Nicomedes77/PlasticBot_v1.0/Modelos 3D/Hardware v1/imagenes/LCD 20x04 (encastre).jpg

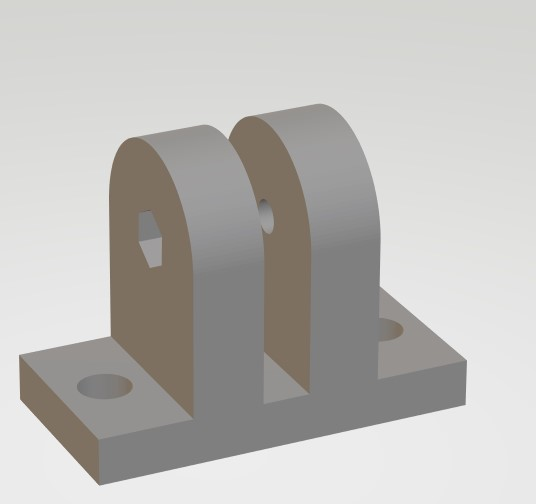
Modelos 3D/Hardware v1/imagenes/LCD 20x04 (encastre).jpg
