Nicomedes77/PlasticBot_v1.0/Modelos 3D/Hardware v1/imagenes/soporte NEMA17.jpg

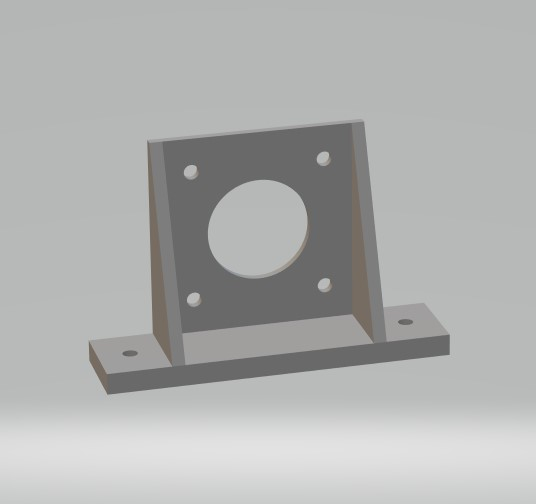
Modelos 3D/Hardware v1/imagenes/soporte NEMA17.jpg
