Nicomedes77/PlasticBot_v1.0/README.md

# Proyecto PlasticBot
- Proyecto colaborativo que busca transformar botellas PET en filamento plastico para impresoras 3D.
- Trabajo final de la carrera de Especialización de Sistemas Embebidos de FIUBA.
- Orientado a instituciones educativas que necesiten filamento para sus impresoras 3D.
