Nicomedes77/PlasticBot_v1.0/Modelos 3D/Hardware v1/imagenes/Encaste para bobina colectora_parteC.jpg

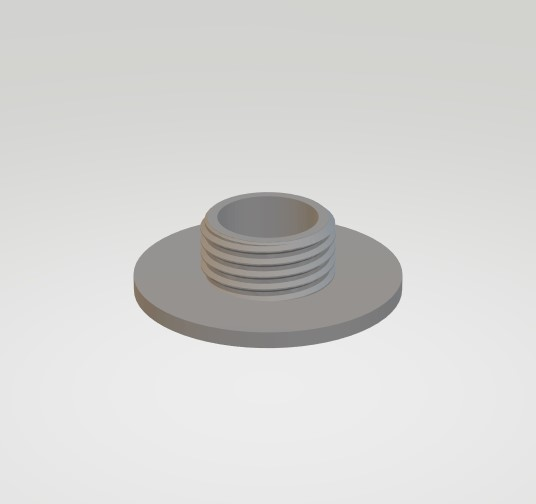
Modelos 3D/Hardware v1/imagenes/Encaste para bobina colectora_parteC.jpg
