Nicomedes77/PlasticBot_v1.0/Modelos 3D/Hardware v1/imagenes/filador tira PET.jpg

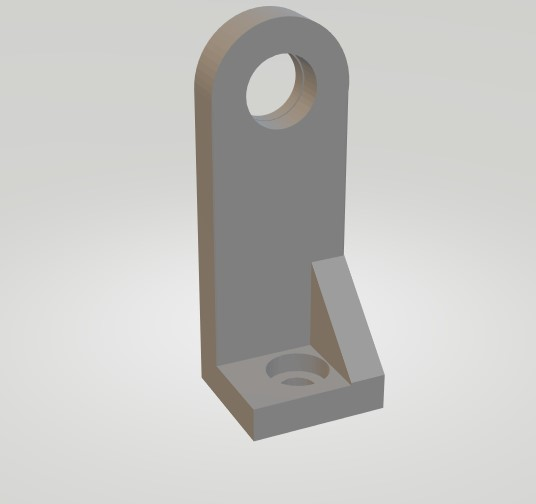
Modelos 3D/Hardware v1/imagenes/filador tira PET.jpg
