Nicomedes77/PlasticBot_v1.0/Modelos 3D/Hardware v1/imagenes/guia_tapa_der.jpg

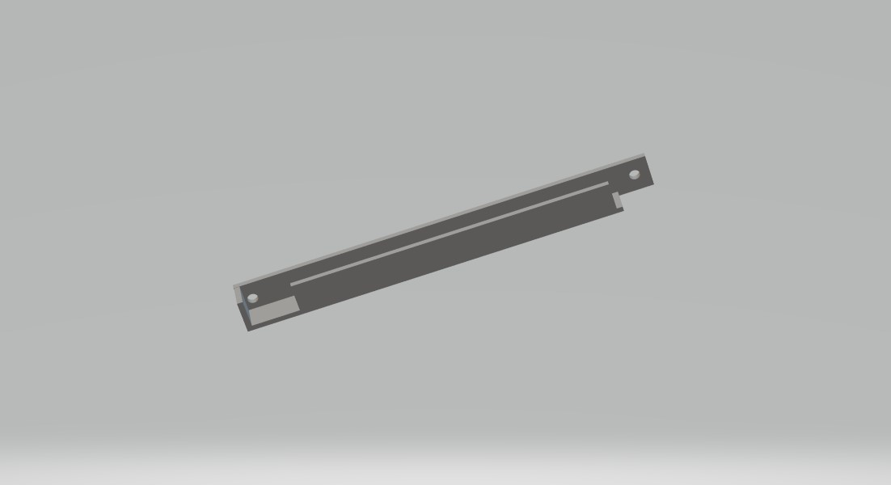
Modelos 3D/Hardware v1/imagenes/guia_tapa_der.jpg
