Nicomedes77/PlasticBot_v1.0/Modelos 3D/Hardware v1/imagenes/guia_tapa_izq.jpg

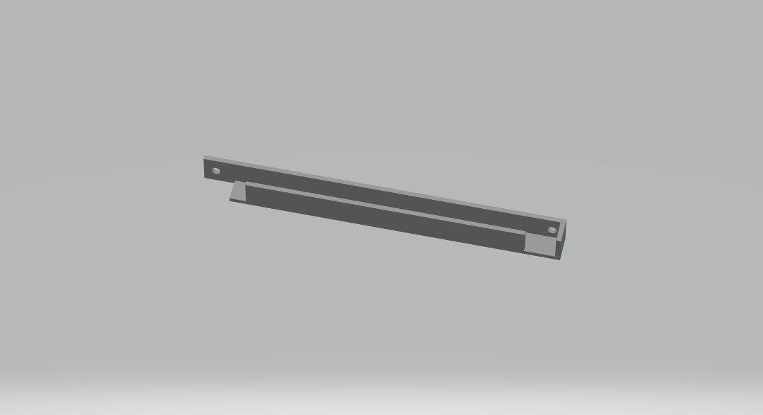
Modelos 3D/Hardware v1/imagenes/guia_tapa_izq.jpg
