Nicomedes77/PlasticBot_v1.0/Modelos 3D/Hardware v1/imagenes/rollo tira PET.png

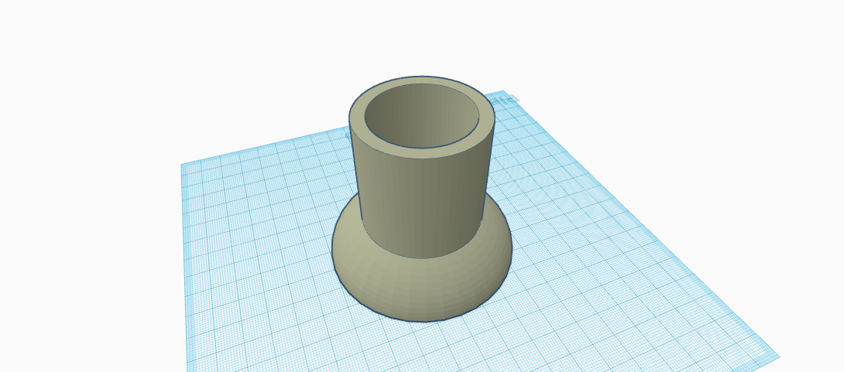
Modelos 3D/Hardware v1/imagenes/rollo tira PET.png
