Nicomedes77/PlasticBot_v1.0/Modelos 3D/Hardware v1/imagenes/Soporte bobina colector filamento parteB.jpg

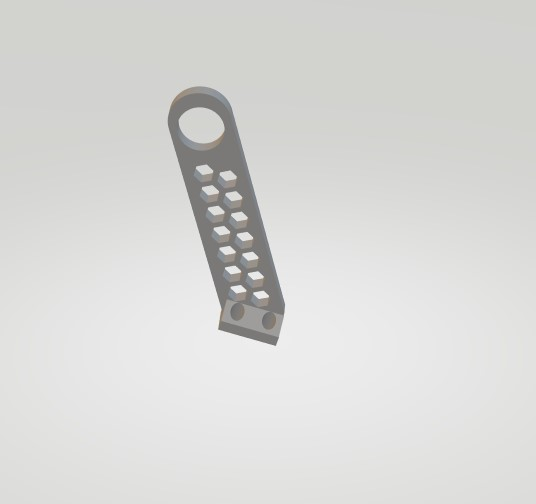
Modelos 3D/Hardware v1/imagenes/Soporte bobina colector filamento parteB.jpg
