Nicomedes77/PlasticBot_v1.0/Modelos 3D/Hardware v1/imagenes/soporte_sensor_filamento.jpg

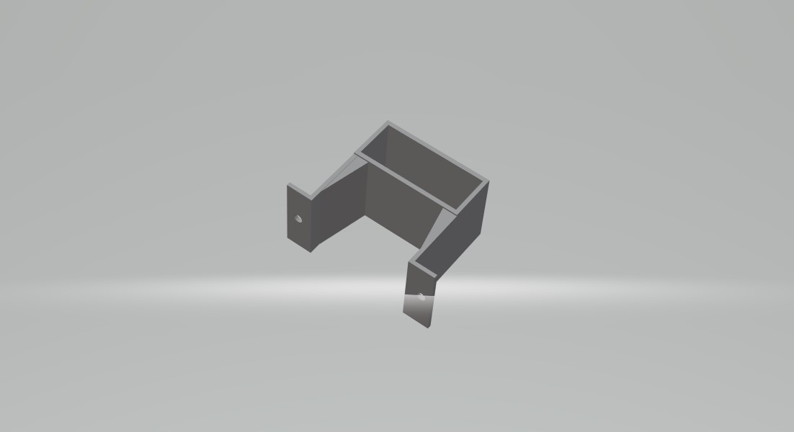
Modelos 3D/Hardware v1/imagenes/soporte_sensor_filamento.jpg
