Nicomedes77/PlasticBot_v1.0/BOM.xlsx

Sheet: Electronica & accesorios 3D
Nombre | cantidad | Nota
Placa de desarrollo "Bluepill" (STM32F103C8T6) (https://drive.google.com/file/d/1hpQ76dLVYaI5o_rDVkLO2Ne1s6q506t4/view?usp=sharing) | 1
Módulo MOSFET IRF520N (https://drive.google.com/file/d/1cJZWBD_wcfqCogvwuu_0CMX1WqDuURyV/view?usp=sharing) | 1
Módulo BUZZER (https://drive.google.com/file/d/1bJPctQ90iFLyjyye83Ye11f-dC5BXUkv/view?usp=sharing) | 1
Led 5 mm (https://drive.google.com/file/d/1oGvvgqCxScbAKbMWBlhJqRlZeoV0u4r3/view?usp=sharing) | 1
resistencia 330 ohm / 1/8W (https://drive.google.com/file/d/1HIooyIruoW-4rPtgbwAZOv_i-Ot9C7bt/view?usp=sharing) | 1
resistencia 4.7 Kohm / 1/8W (https://drive.google.com/file/d/1ij4iOs_i9iZRbYxjXlwnQBV02DJ9Dd3c/view?usp=sharing) | 1
capacitor electrolitico 10 uf / 50V (https://drive.google.com/file/d/1pf3eecrNbL37Hb7Q81hdsruip2whxTfo/view?usp=sharing) | 1
capacitor electrolitico 100 uf / 50V (https://drive.google.com/file/d/1SXGDAdWLtYe4i_imld9zDZRDrq1E_L0E/view?usp=sharing) | 1
capacitor ceramico 100 nf / 25V (https://drive.google.com/file/d/1JHIaDz-pbmhIrKoVfPXcqYOIapL2rS7f/view?usp=sharing) | 2
Portaled 5 mm (https://drive.google.com/file/d/1zlr5Kzio6i0sBJQEwDiup6KGgjH0xvGb/view?usp=sharing) | 1
Driver 4988 (https://drive.google.com/file/d/1dHWgvLTxTvCki5mFs26nIUVMRjE5rpnB/view?usp=sharing) | 1
Display LCD 20x04 + conversor I2C (PCF8574) (https://drive.google.com/file/d/1RT0fB2h7F7PUxKKvL3I1MBF4UiUku6NH/view?usp=sharing) | 1
Motor NEMA17 (https://drive.google.com/file/d/1F3JRY_0RIWxxpnp9B42qQUj8Dj778M6k/view?usp=sharing) | 1
Fuente switching 5V 1A (https://drive.google.com/file/d/1SEN_R0MhTD34jfJKpHSXYYEtGUPfHV0O/view?usp=sharing) | 1
Fuente switching 12V 5A (https://drive.google.com/file/d/1mL4vIOPmZObwk09g1XBh2ct2ecdEO_3N/view?usp=sharing) | 1
Termistor NTC 100K b3950 (https://drive.google.com/file/d/1QHox2p5YeMVsQNFzTtSdoyU3abRl5UYC/view?usp=sharing) | 1
Calefactor 12V 40W (https://drive.google.com/file/d/18slzmpn_nLxzlRNlSquxBkXJR-uAIbbI/view?usp=sharing) | 1
Bloque aluminio hotend E3D (https://drive.google.com/file/d/1PXSPaz2dTPzWu5iFJci-ekA_c01seFG3/view?usp=sharing) | 1
Cooler VD6020HS (https://drive.google.com/file/d/1aeMtpcaGHz84NbaCIv4d7kyVq9lUK1Zj/view?usp=sharing) | 1
Llave interruptora 10A (https://drive.google.com/file/d/1_eC3LxGiZ6Imny3WjnHTNs7RwZ-kn9Td/view?usp=sharing) | 1

Sheet: Piezas a imprimir
Nombre | cantidad | Nota
perilla encoder (https://drive.google.com/file/d/1aTwbA7jsxbm-5I54wP7U5kSs88Q0ahjX/view?usp=sharing) | 1
LCD 20x04 (parte trasera) (https://drive.google.com/file/d/1kNfTovGW_0oGpc532PjFX7qjzmkr2Byo/view?usp=sharing) | 1
LCD 20x04 (parte delantera) (https://drive.google.com/file/d/1Z2yhQUX07at6b5tUAnCE98tqZ3-ptcvd/view?usp=sharing) | 1
LCD 20x04 (encastre) (https://drive.google.com/file/d/19xl55VTQOF__a2um06VgkUQcstboAvjf/view?usp=sharing) | 1
soporte motor nema17 (https://drive.google.com/file/d/15d8GA80SN-JBsfgM4QyWjDQemHA-GUAd/view?usp=sharing) | 1
rodamiento para eje de motor (https://drive.google.com/file/d/17Kx38daUXOLfDESTDvb5b7mgYgzrlufQ/view?usp=sharing) | 1
Encaste para bobina colectora (parte A) (https://drive.google.com/file/d/1PMw3cpKJkdK4uuDisPJ7X8xeIUzu0h2e/view?usp=sharing) | 1
Encaste para bobina colectora (parte B) (https://drive.google.com/file/d/1jLKY_rFNyguklqIbYr01J1MFEAmTEgQf/view?usp=sharing) | 1
Encaste para bobina colectora (parte C) (https://drive.google.com/file/d/184IqcKPgTFFMZS2oCmmv10lcVTAB6hZe/view?usp=sharing) | 1
Encaste para bobina colectora (parte D) (https://drive.google.com/file/d/1l7X9P5o-G5x70V5vFXfjceNGwdPV96Xz/view?usp=sharing) | 1
Encaste para bobina colectora (parte E) (https://drive.google.com/file/d/1wEdfKx7sQRdYPW4NWWMbQKxhzlbf56m8/view?usp=sharing) | 1
Encaste para bobina colectora (parte F) (https://drive.google.com/file/d/1UNIPjelLCezCFERAI2C5lZmNbCrOpZoz/view?usp=sharing) | 1
Encaste para bobina colectora (parte G) (https://drive.google.com/file/d/1zcVAUyDe42qEDLgXaKr_hbPnNmbJGTxJ/view?usp=sharing) | 1
guia tira PET (https://drive.google.com/file/d/1rB111pQd3qcu5wQFEIXSJVQJzvkFlWZM/view?usp=sharing) | 1
guia filamento (https://drive.google.com/file/d/12fOAk-A6jRqsngE_1ypJ1siqr4f3jMgk/view?usp=sharing) | 1
rollo tira PET (https://drive.google.com/file/d/1DmXIf07j8GghnDZvQ-Z0xZ8U-AxyPekK/view?usp=sharing) | 4 | Dos piezas deben unirse para formar un rollo. Se pide 4 piezas para formar dos rollos.
Soporte bobina colectora de filamento (parte A) (https://drive.google.com/file/d/1PuO3yaOQ7Fxi_LlXLZb5tXpA20s7-0Dd/view?usp=sharing) | 1
Soporte bobina colectora de filamento (parte B) (https://drive.google.com/file/d/1YSYdvTT1PMcpUSaRXzZNAROwUiIeuCQP/view?usp=sharing) | 1
Soporte sensor filamento (https://drive.google.com/file/d/1DXoEKxG6uN81Ux30Y7fD32JI-4n-xDrn/view?usp=sharing) | 1
Guia tapa trasera de plataforma (Derecha) (https://drive.google.com/file/d/1REhEHMpPzvmPh371l8Kj3iusdAmQd_bd/view?usp=sharing) | 1
Guia tapa trasera de plataforma (Izquierda) (https://drive.google.com/file/d/11k_DMg8fDH8LXYoIzecTBzy8kUevcMzh/view?usp=sharing) | 1

Sheet: Piezas y herramientas complemen
Nombre | cantidad | Nota
Angulo metálico (https://drive.google.com/file/d/1jP8p5TjdTBiJcK7Ow22nk1GjOA1KDdjo/view?usp=sharing) | 1 | Se usa para fijar extrusor
tornillos M3 6mm | 4 | Fijación motor NEMA17
tornillos M3 20mm | 20 | - Fijación soporte LCD. - Filación guia tira PET. - Fijación guía filamento. - Fijación soporte de bobina colectora. - Fijación soporte motor NEMA17. - Fijación angulo metalico para extrusor. - Fijación para soporte de sensor de filamento.
tuerca para M3 | 20
arandelas para M3 | 20
Clavos finos | 40 | Se usan para unir los lados de la platafora del equipo
Taladro | 1
mecha para madera de 8 mm | 1
mecha para madera de 6 mm | 1
Caladora para madera | 1
Destornilladores
Llaves Allen para los tornillos M3
placa MDF 200x480x12 mm | 2 | Seguir las perforaciones aproximadas en los planos (https://drive.google.com/drive/folders/1a34v3ecpyutxYyMpBvW9Bo1lMB2Hc5o2?usp=sharing)
placa MDF 120x475x3 mm | 1 | Seguir las perforaciones aproximadas en los planos (https://drive.google.com/drive/folders/1a34v3ecpyutxYyMpBvW9Bo1lMB2Hc5o2?usp=sharing)
placa MDF 120x200x3 mm | 2 | Seguir las perforaciones aproximadas en los planos (https://drive.google.com/drive/folders/1a34v3ecpyutxYyMpBvW9Bo1lMB2Hc5o2?usp=sharing)
placa MDF 120x480x3 mm | 1 | Seguir las perforaciones aproximadas en los planos (https://drive.google.com/drive/folders/1a34v3ecpyutxYyMpBvW9Bo1lMB2Hc5o2?usp=sharing)
