Nicomedes77/PlasticBot_v1.0/Modelos 3D/Hardware v1/archivos/Display + encoder/LCD 20x04 (encastre).stl

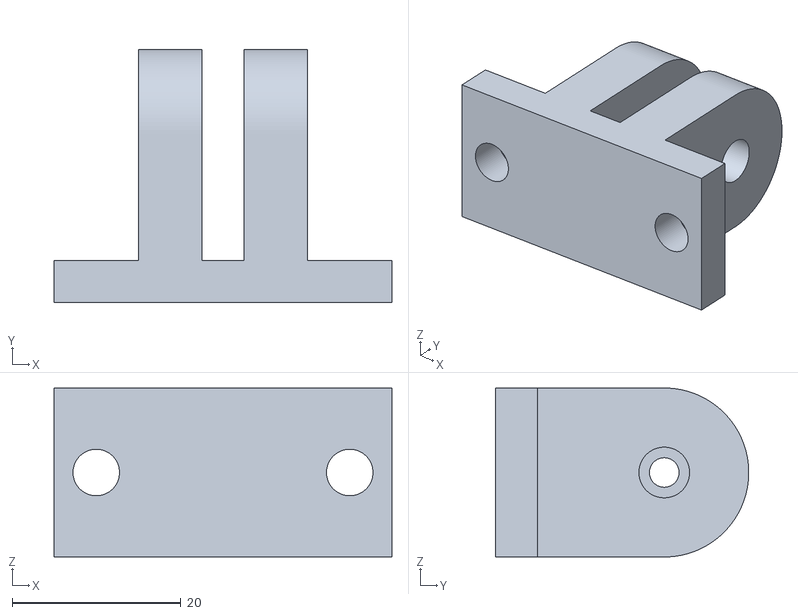
[picture p21: CAD file, 2023-06-16]
Modelos 3D/Hardware v1/archivos/Display + encoder/LCD 20x04 (encastre).stl
40.0 x 30.0 x 20.0
