Nicomedes77/PlasticBot_v1.0/Modelos 3D/Hardware v1/archivos/guia tapa trasera (izquierda).stl

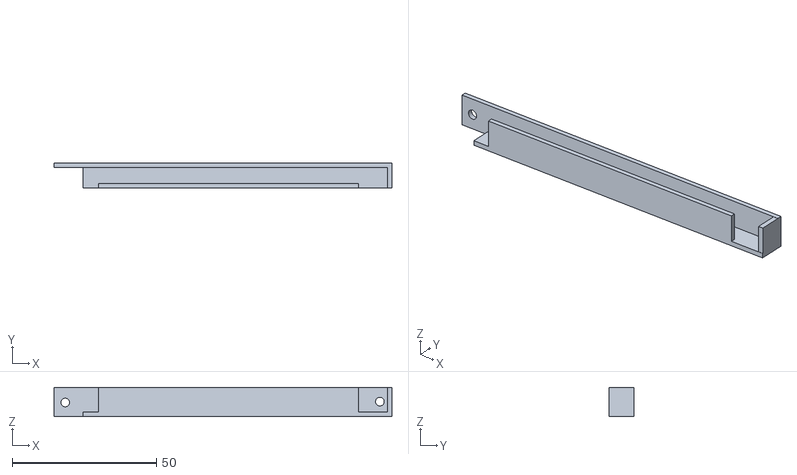
[picture p22: CAD file, 2023-06-16]
Modelos 3D/Hardware v1/archivos/guia tapa trasera (izquierda).stl
117.0 x 8.70 x 10.1
