Nicomedes77/PlasticBot_v1.0/Modelos 3D/Hardware v1/archivos/motor NEMA17/rodamiento para eje de motor.stl

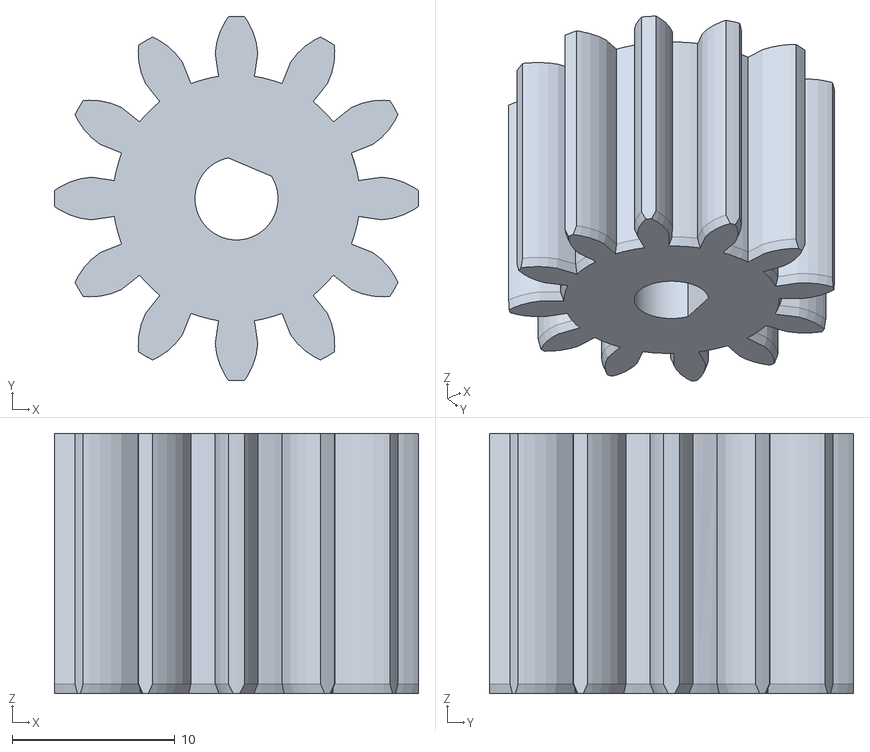
[picture p23: CAD file, 2023-06-16]
Modelos 3D/Hardware v1/archivos/motor NEMA17/rodamiento para eje de motor.stl
22.4 x 22.4 x 16.0
