Nicomedes77/PlasticBot_v1.0/Modelos 3D/RECREATOR 3D Files/RECREATOR3D - Part 6A - encaste para bobina colectora (rodamiento) v2.stl

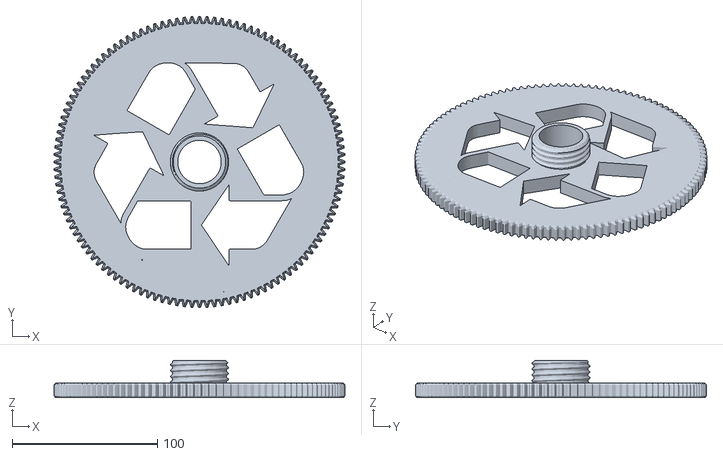
[picture p24: CAD file, 2023-06-16]
Modelos 3D/RECREATOR 3D Files/RECREATOR3D - Part 6A - encaste para bobina colectora (rodamiento) v2.stl
200.2 x 200.2 x 25.6
