Nicomedes77/PlasticBot_v1.0/Planos maqueta/plano superior.dxf

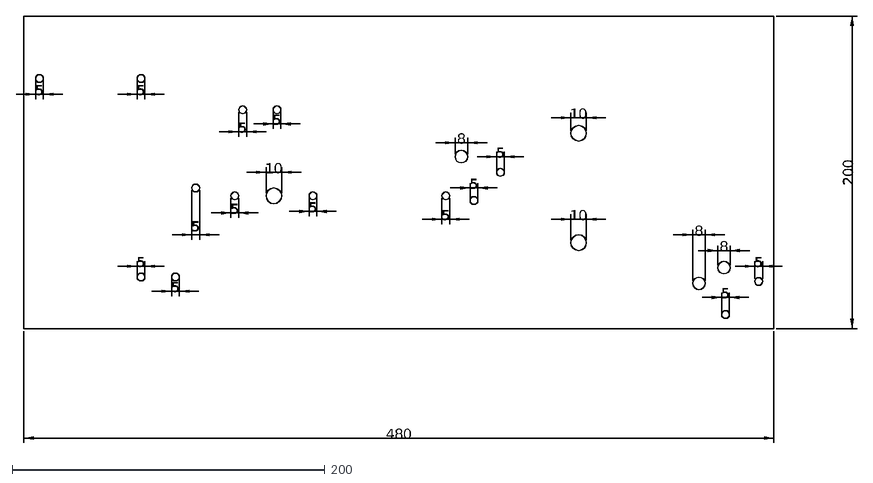
[picture p25: CAD file, 2023-06-16]
Planos maqueta/plano superior.dxf
480
200
10
8
5
