Nicomedes77/PlasticBot_v1.0/Modelos 3D/Hardware v1/archivos/Display + encoder/LCD 20x04 (parte trasera).stl

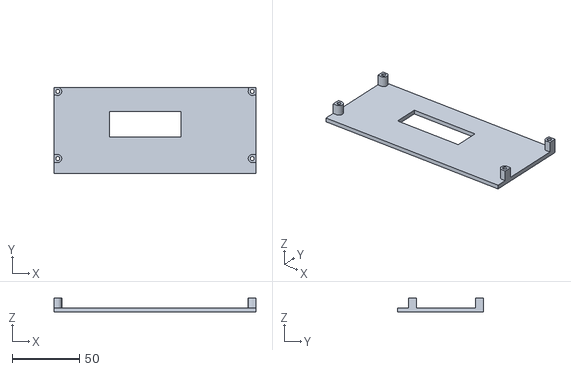
[picture p26: CAD file, 2023-06-16]
Modelos 3D/Hardware v1/archivos/Display + encoder/LCD 20x04 (parte trasera).stl
150.6 x 63.8 x 10.6
