Nicomedes77/PlasticBot_v1.0/Modelos 3D/Hardware v1/archivos/Encaste para bobina colectora (parte D).stl

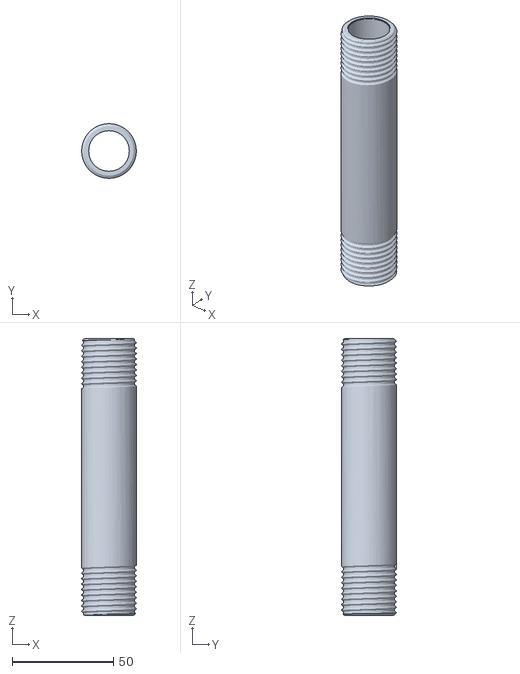
[picture p27: CAD file, 2023-06-16]
Modelos 3D/Hardware v1/archivos/Encaste para bobina colectora (parte D).stl
27.0 x 27.0 x 136.7
