Nicomedes77/PlasticBot_v1.0/Modelos 3D/Hardware v1/archivos/motor NEMA17/soporte motor nema17.stl

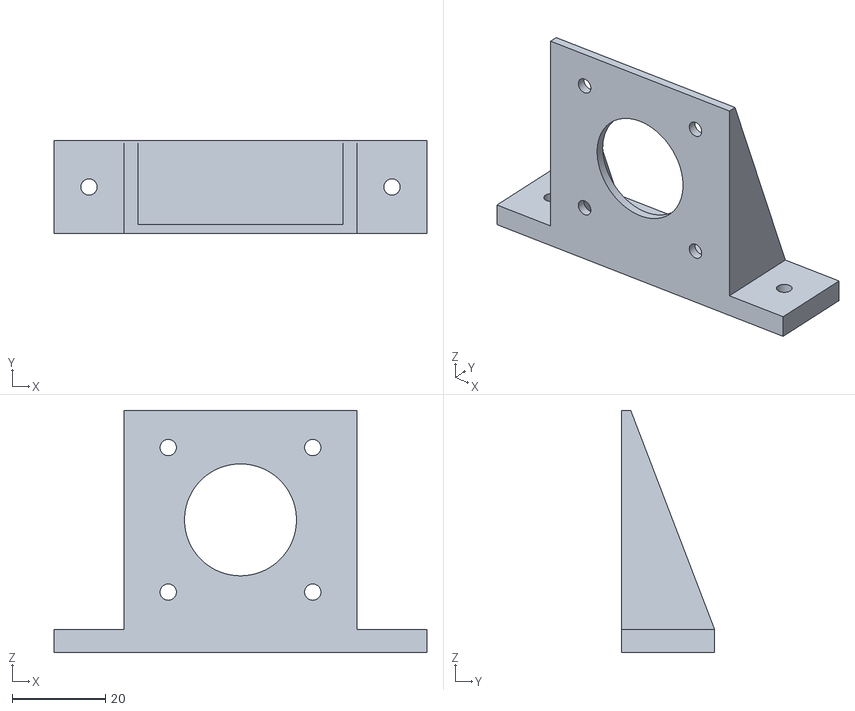
[picture p28: CAD file, 2023-06-16]
Modelos 3D/Hardware v1/archivos/motor NEMA17/soporte motor nema17.stl
80.0 x 20.0 x 52.0
