Nicomedes77/PlasticBot_v1.0/Modelos 3D/RECREATOR 3D Files/RECREATOR3D - Part 5B - Soporte bobina colectora de filamento.stl

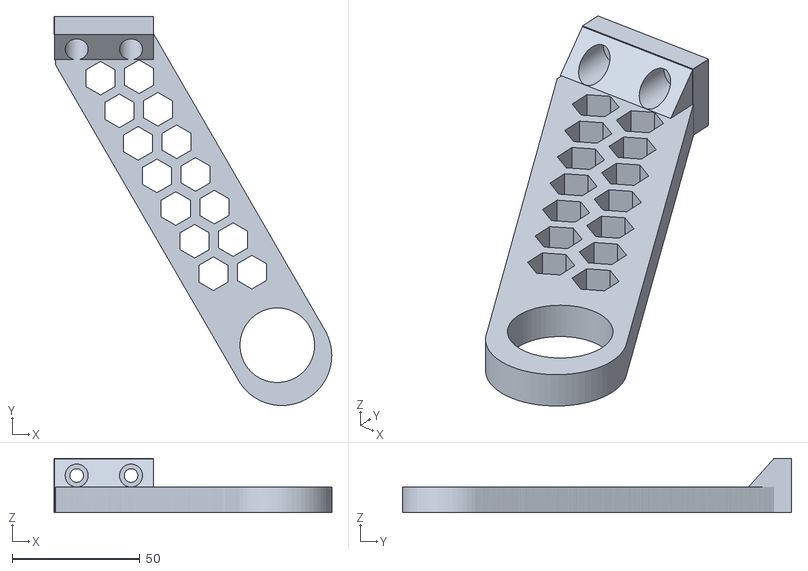
[picture p29: CAD file, 2023-06-16]
Modelos 3D/RECREATOR 3D Files/RECREATOR3D - Part 5B - Soporte bobina colectora de filamento.stl
108.6 x 152.2 x 21.3
