Nicomedes77/PlasticBot_v1.0/Planos maqueta/laterales.dxf

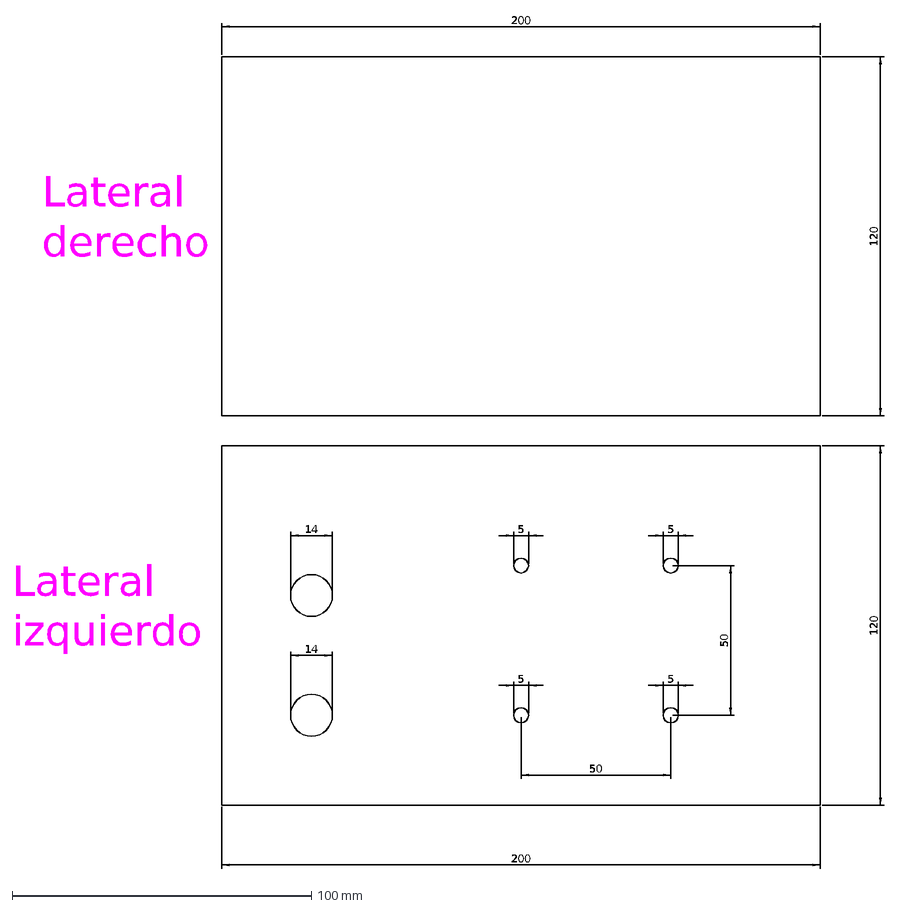
[picture p30: CAD file, 2023-06-16]
Planos maqueta/laterales.dxf
200
120
Lateral izquierdo
Lateral derecho
14
5
50
