Nicomedes77/PlasticBot_v1.0/Modelos 3D/Hardware v1/archivos/Display + encoder/LCD 20x04 (parte delantera).stl

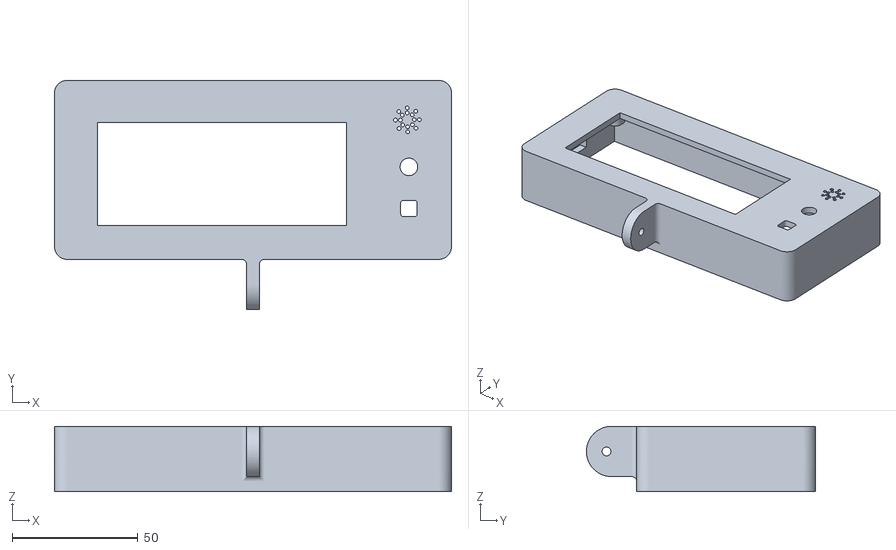
[picture p31: CAD file, 2023-06-16]
Modelos 3D/Hardware v1/archivos/Display + encoder/LCD 20x04 (parte delantera).stl
158.0 x 91.2 x 26.0
