Nicomedes77/PlasticBot_v1.0/Modelos 3D/Hardware v1/archivos/Encaste para bobina colectora (parte G).stl

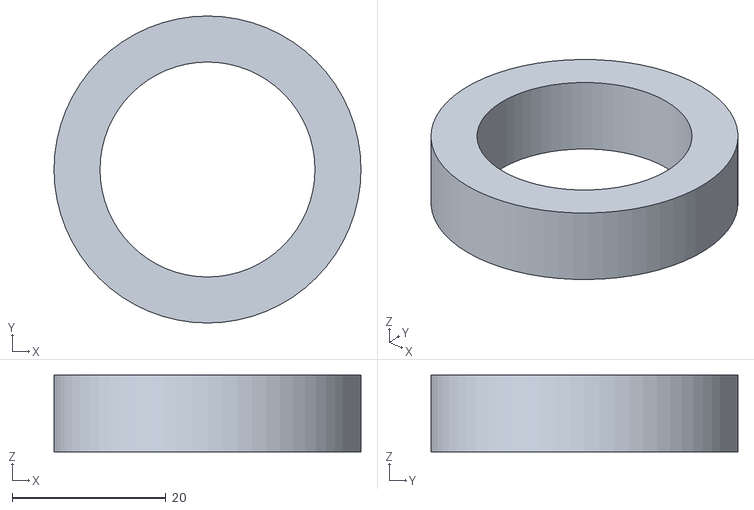
[picture p32: CAD file, 2023-06-16]
Modelos 3D/Hardware v1/archivos/Encaste para bobina colectora (parte G).stl
40.0 x 40.0 x 10.00
