Nicomedes77/PlasticBot_v1.0/Planos maqueta/frente_atras.dxf

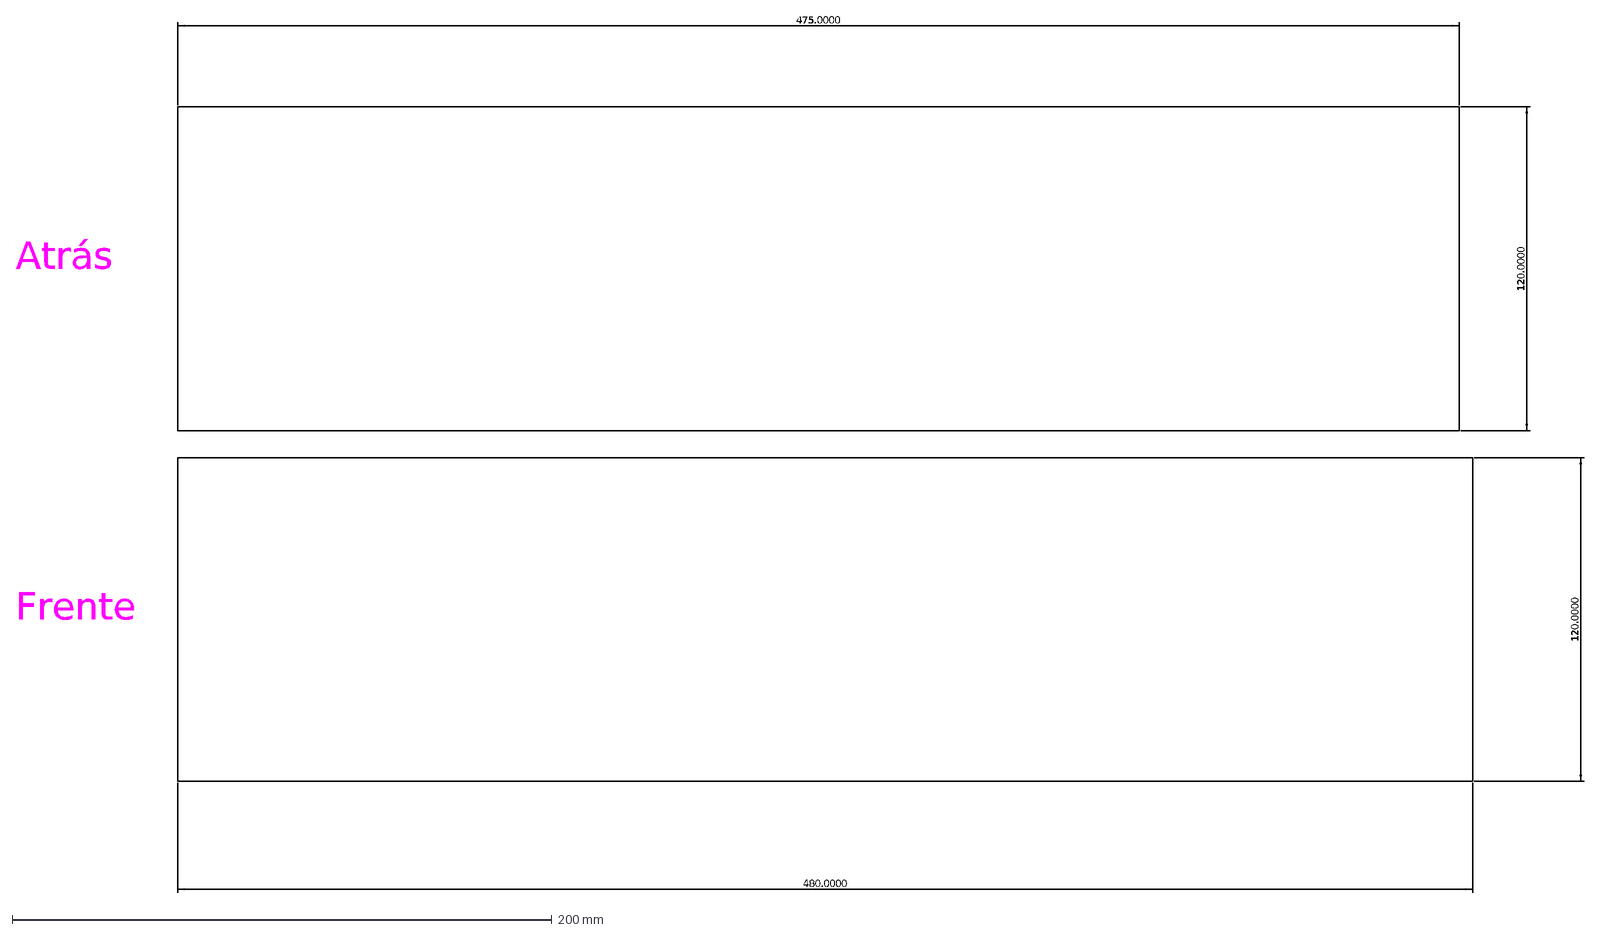
[picture p33: CAD file, 2023-06-16]
Planos maqueta/frente_atras.dxf
120.0000
480.0000
475.0000
Frente
Atrás
