Nicomedes77/PlasticBot_v1.0/Modelos 3D/Hardware v1/archivos/Display + encoder/perilla encoder.stl

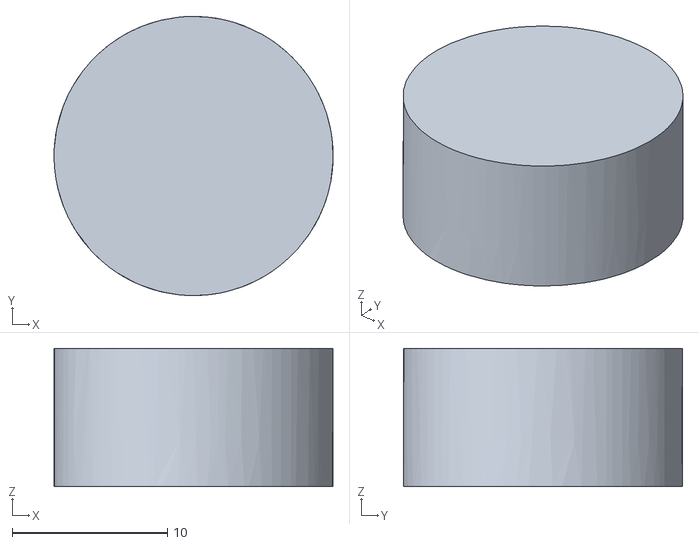
[picture p34: CAD file, 2023-06-16]
Modelos 3D/Hardware v1/archivos/Display + encoder/perilla encoder.stl
18.0 x 18.0 x 8.90
