Nicomedes77/PlasticBot_v1.0/Modelos 3D/Hardware v1/archivos/Encaste para bobina colectora (parte E).stl

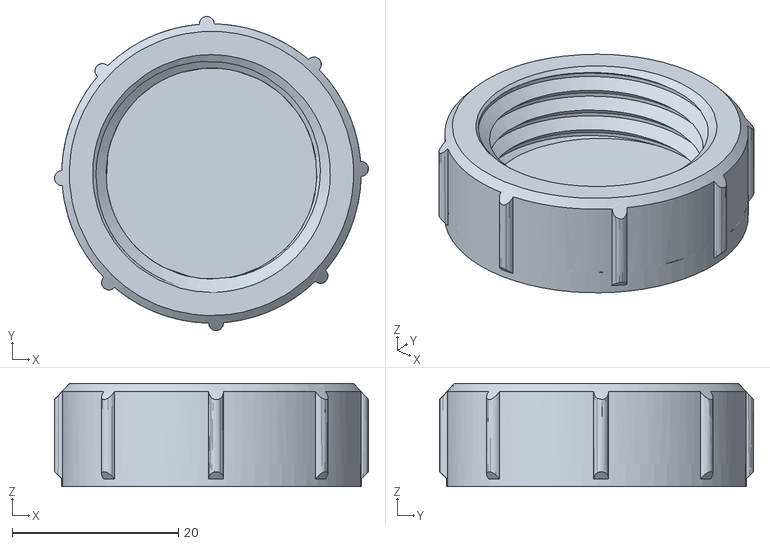
[picture p35: CAD file, 2023-06-16]
Modelos 3D/Hardware v1/archivos/Encaste para bobina colectora (parte E).stl
37.7 x 37.8 x 12.4
