Nicomedes77/PlasticBot_v1.0/Modelos 3D/RECREATOR 3D Files/RECREATOR3D - Part 5A - Soporte bobina colectora de filamento.stl

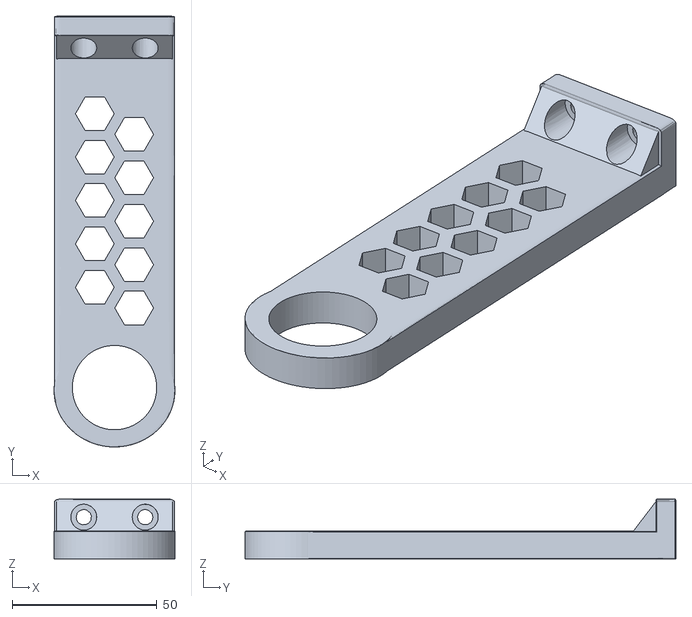
[picture p36: CAD file, 2023-06-16]
Modelos 3D/RECREATOR 3D Files/RECREATOR3D - Part 5A - Soporte bobina colectora de filamento.stl
41.9 x 149.1 x 20.7
