Nicomedes77/PlasticBot_v1.0/Modelos 3D/Hardware v1/archivos/Encaste para bobina colectora (parte C).stl

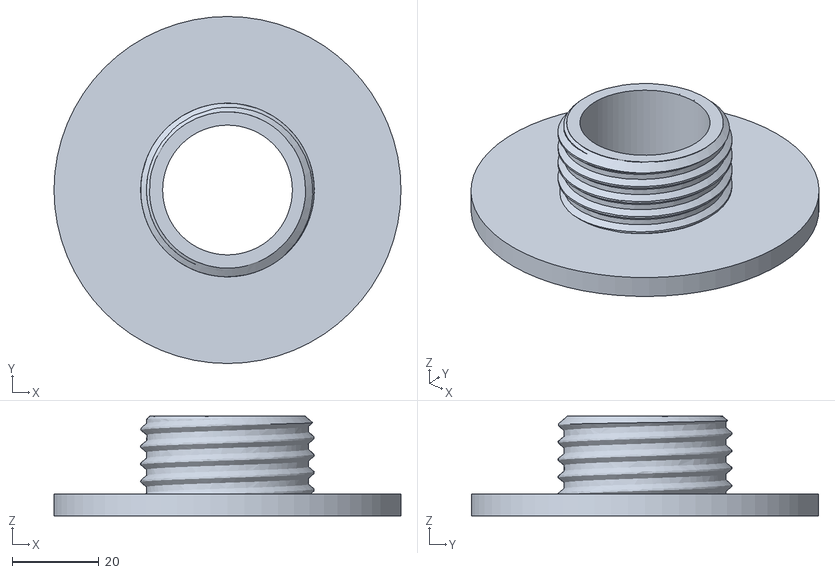
[picture p37: CAD file, 2023-06-16]
Modelos 3D/Hardware v1/archivos/Encaste para bobina colectora (parte C).stl
80.0 x 80.0 x 23.0
