Nicomedes77/PlasticBot_v1.0/Modelos 3D/RECREATOR 3D Files/RECREATOR3D - Part 4A - Orientador de filamento.stl

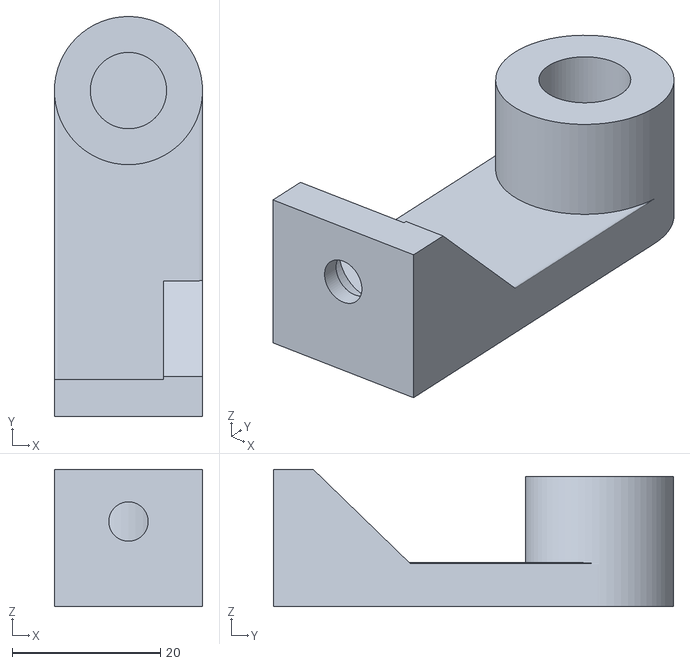
[picture p38: CAD file, 2023-06-16]
Modelos 3D/RECREATOR 3D Files/RECREATOR3D - Part 4A - Orientador de filamento.stl
20.0 x 54.0 x 18.5
