Nicomedes77/PlasticBot_v1.0/Modelos 3D/Hardware v1/archivos/Encaste para bobina colectora (parte A)v2.stl

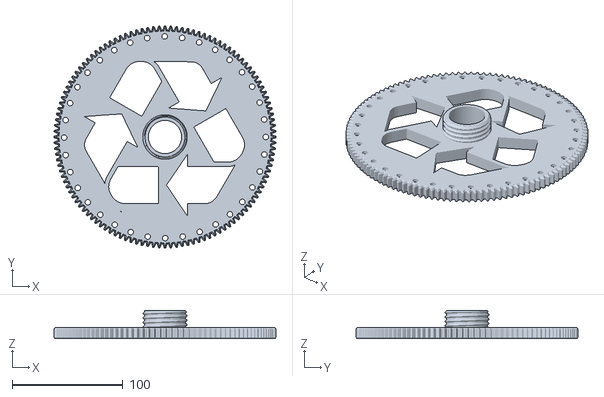
[picture p39: CAD file, 2023-06-16]
Modelos 3D/Hardware v1/archivos/Encaste para bobina colectora (parte A)v2.stl
200.2 x 200.2 x 25.6
