Nicomedes77/PlasticBot_v1.0/Modelos 3D/RECREATOR 3D Files/RECREATOR3D - Part 2 - Heater Block Plate - PETG.stl

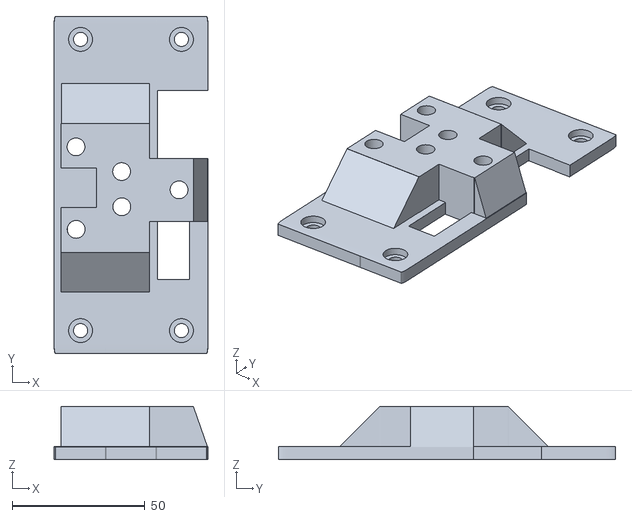
[picture p41: CAD file, 2023-06-16]
Modelos 3D/RECREATOR 3D Files/RECREATOR3D - Part 2 - Heater Block Plate - PETG.stl
58.0 x 127.0 x 20.1
