Nicomedes77/PlasticBot_v1.0/Modelos 3D/Hardware v1/archivos/filador tira PET.stl

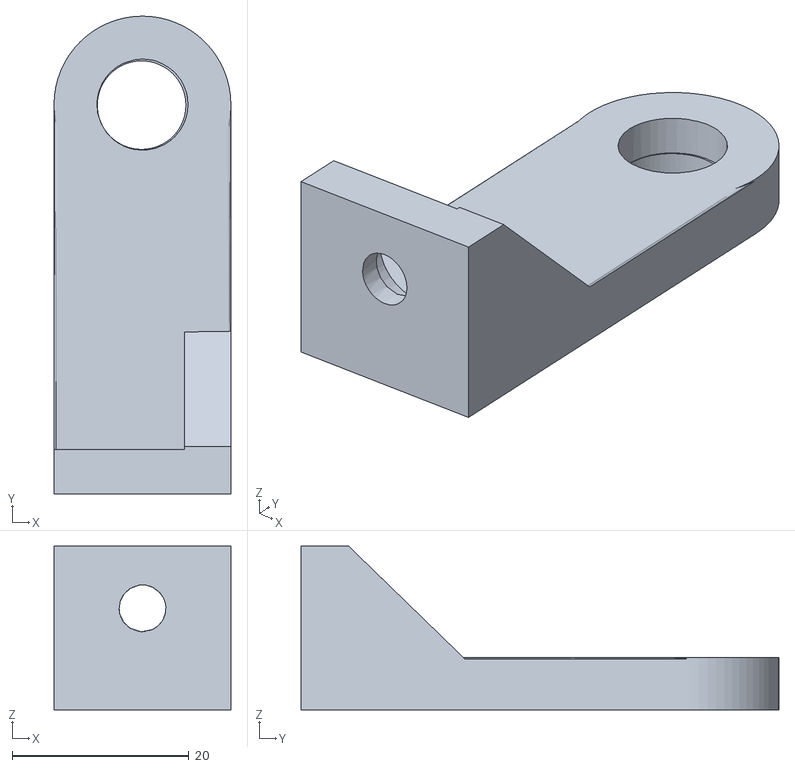
[picture p42: CAD file, 2023-06-16]
Modelos 3D/Hardware v1/archivos/filador tira PET.stl
20.0 x 54.0 x 18.5
