Nicomedes77/PlasticBot_v1.0/Modelos 3D/RECREATOR 3D Files/RECREATOR3D - Part 4D - Orientador de filamento.stl

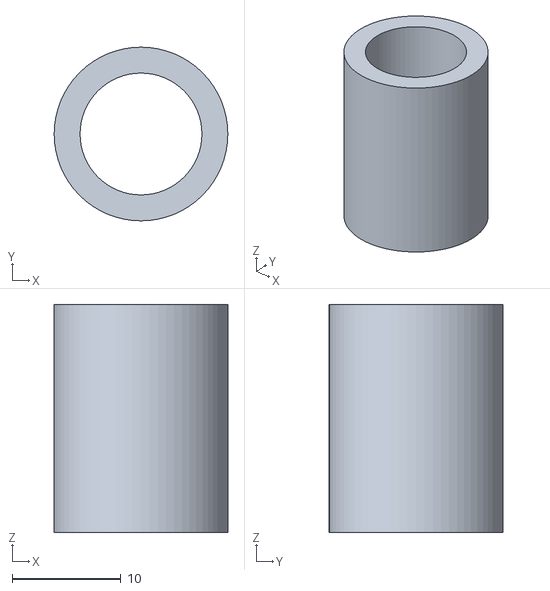
[picture p43: CAD file, 2023-06-16]
Modelos 3D/RECREATOR 3D Files/RECREATOR3D - Part 4D - Orientador de filamento.stl
16.0 x 16.0 x 21.0
