Nicomedes77/PlasticBot_v1.0/Modelos 3D/Hardware v1/archivos/rollo tira PET.stl

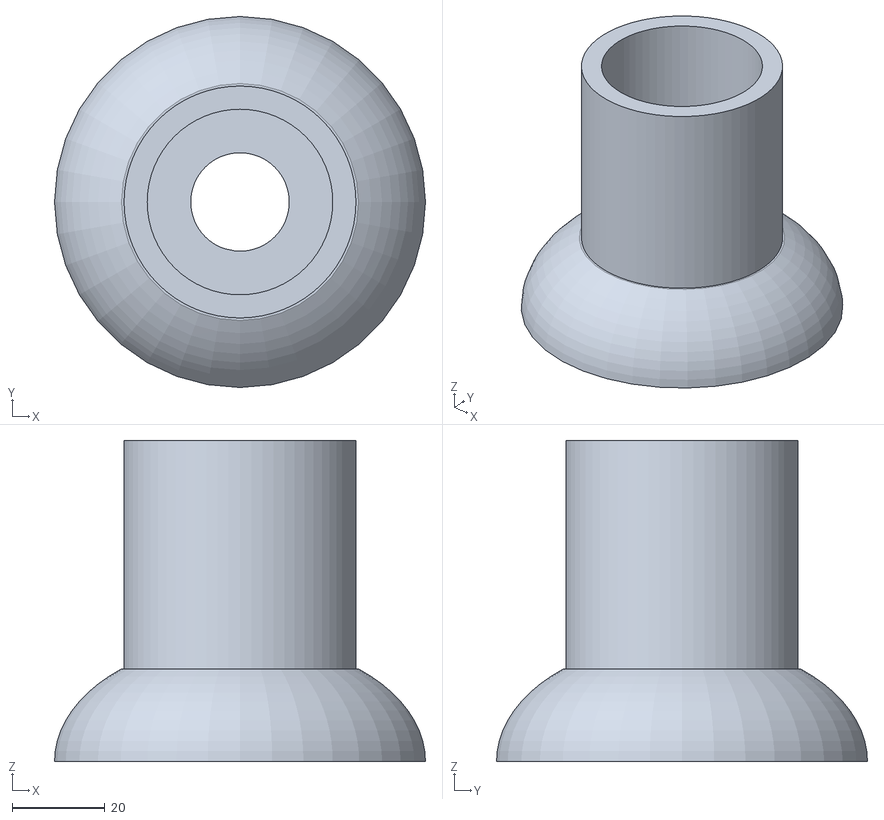
[picture p44: CAD file, 2023-06-16]
Modelos 3D/Hardware v1/archivos/rollo tira PET.stl
80.0 x 80.0 x 69.3
