Nicomedes77/PlasticBot_v1.0/Modelos 3D/RECREATOR 3D Files/RECREATOR3D - Part 11C - Front Sinage (esta de mas).stl

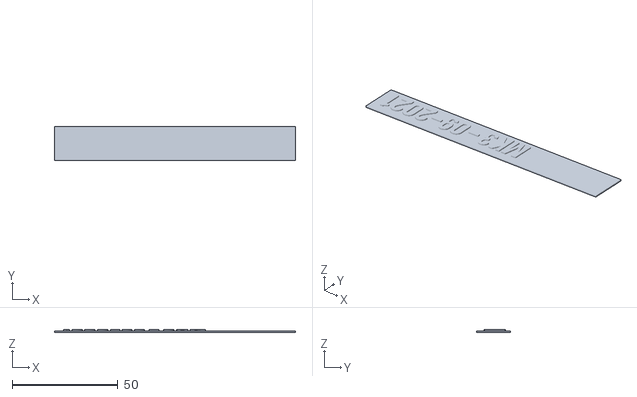
[picture p45: CAD file, 2023-06-16]
Modelos 3D/RECREATOR 3D Files/RECREATOR3D - Part 11C - Front Sinage (esta de mas).stl
113.7 x 16.0 x 1.20
