Nicomedes77/PlasticBot_v1.0/Modelos 3D/Hardware v1/archivos/soporte sensor filamento.stl

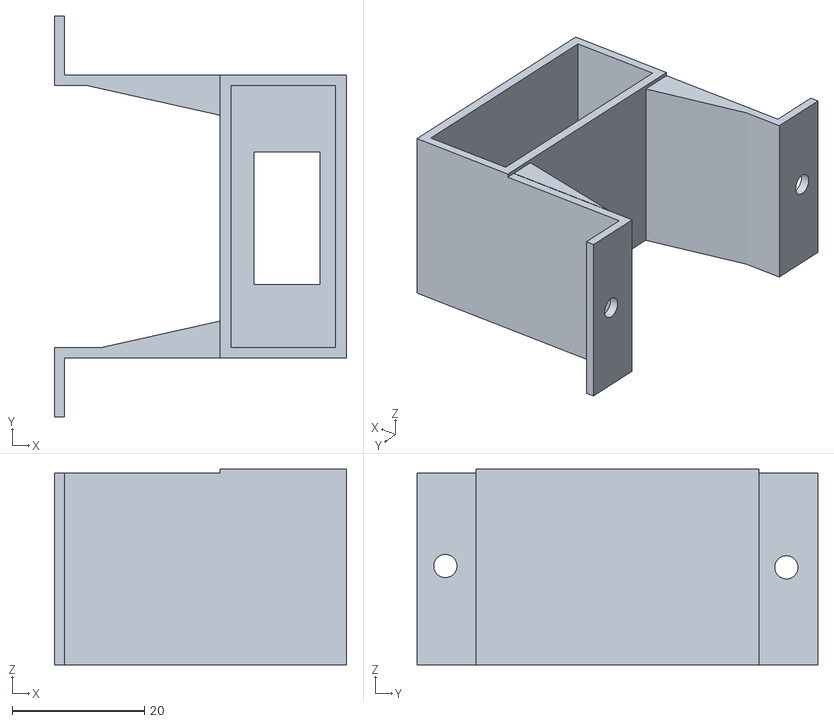
[picture p46: CAD file, 2023-06-16]
Modelos 3D/Hardware v1/archivos/soporte sensor filamento.stl
44.1 x 60.5 x 29.6
