Nicomedes77/PlasticBot_v1.0/Modelos 3D/RECREATOR 3D Files/RECREATOR3D - Part 6B - encaste para bobina colectora (rodamiento).stl

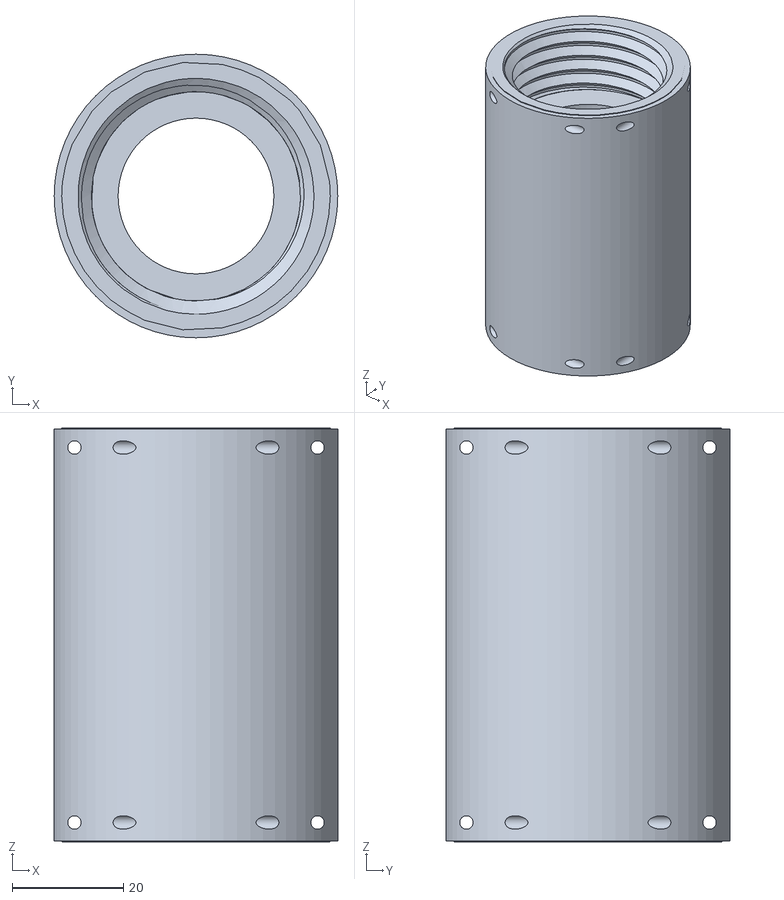
[picture p47: CAD file, 2023-06-16]
Modelos 3D/RECREATOR 3D Files/RECREATOR3D - Part 6B - encaste para bobina colectora (rodamiento).stl
51.0 x 51.0 x 74.4
