Nicomedes77/PlasticBot_v1.0/Modelos 3D/RECREATOR 3D Files/RECREATOR3D - Part 09A - Bottle Support Holder.stl

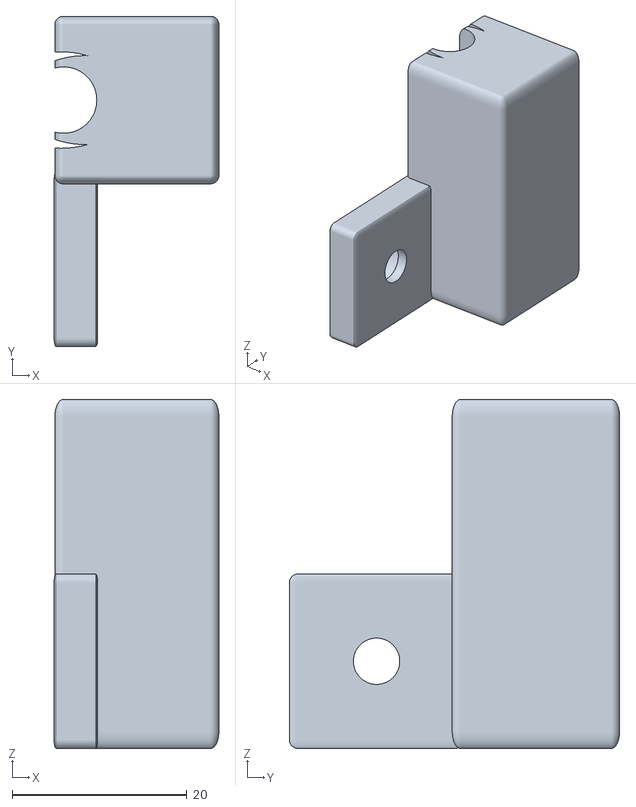
[picture p48: CAD file, 2023-06-16]
Modelos 3D/RECREATOR 3D Files/RECREATOR3D - Part 09A - Bottle Support Holder.stl
18.9 x 37.9 x 40.0
