Nicomedes77/PlasticBot_v1.0/Modelos 3D/RECREATOR 3D Files/RECREATOR3D - Part 8 - rodamiento para NEMA_2.stl

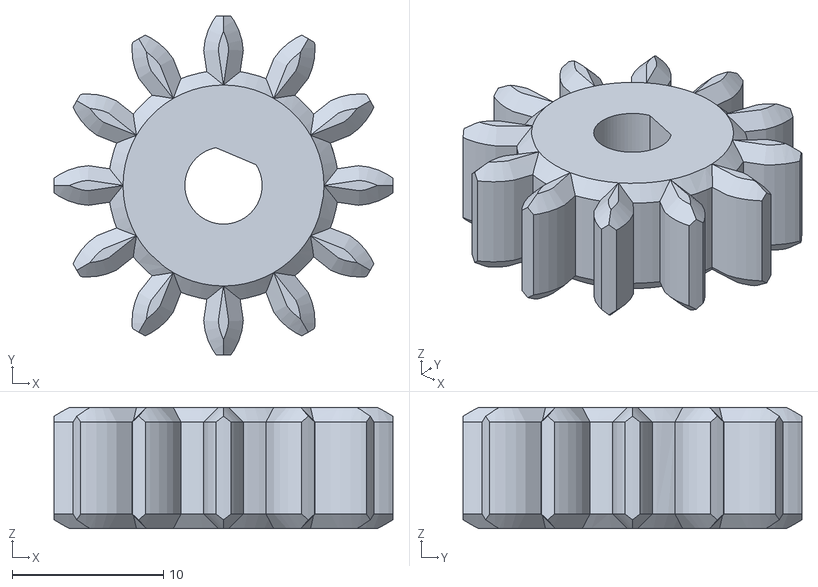
[picture p49: CAD file, 2023-06-16]
Modelos 3D/RECREATOR 3D Files/RECREATOR3D - Part 8 - rodamiento para NEMA_2.stl
22.4 x 22.4 x 8.00
