Nicomedes77/PlasticBot_v1.0/Modelos 3D/RECREATOR 3D Files/RECREATOR3D - Part 10B - Bottle Weight Top.stl

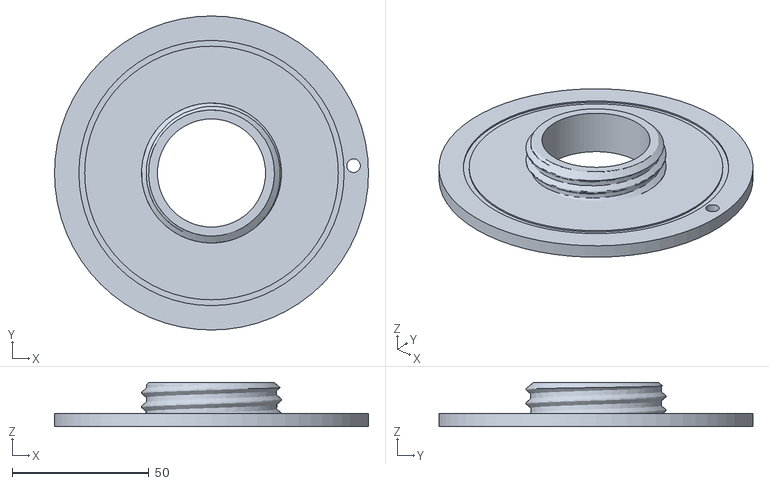
[picture p50: CAD file, 2023-06-16]
Modelos 3D/RECREATOR 3D Files/RECREATOR3D - Part 10B - Bottle Weight Top.stl
114.9 x 114.9 x 16.2
