Nicomedes77/PlasticBot_v1.0/Modelos 3D/RECREATOR 3D Files/RECREATOR3D - Part 4C - Orientador de filamento.stl

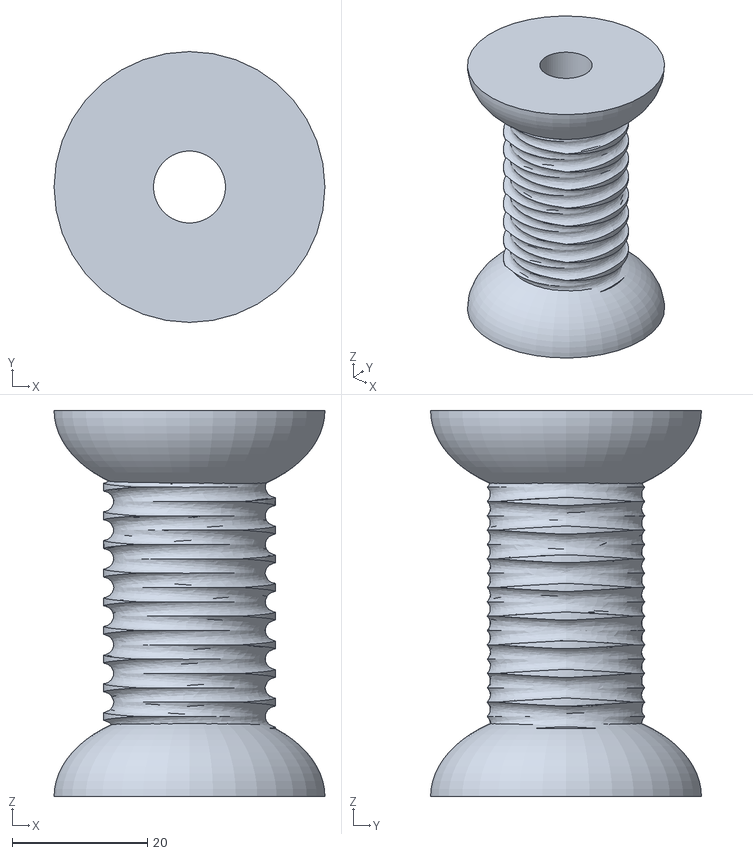
[picture p51: CAD file, 2023-06-16]
Modelos 3D/RECREATOR 3D Files/RECREATOR3D - Part 4C - Orientador de filamento.stl
40.0 x 40.0 x 57.0
