Nicomedes77/PlasticBot_v1.0/Modelos 3D/RECREATOR 3D Files/RECREATOR3D - Part 11B - Front Sinage (esta de mas).stl

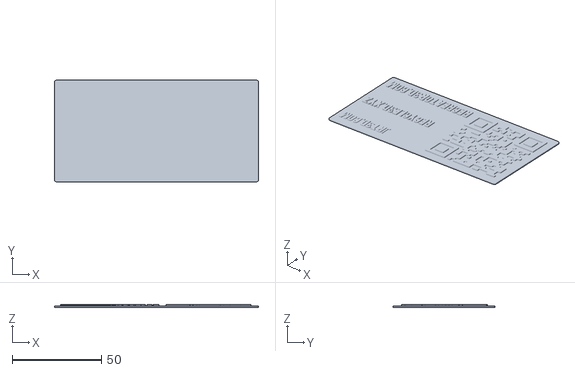
[picture p53: CAD file, 2023-06-16]
Modelos 3D/RECREATOR 3D Files/RECREATOR3D - Part 11B - Front Sinage (esta de mas).stl
114.3 x 57.1 x 1.60
