Nicomedes77/PlasticBot_v1.0/Modelos 3D/RECREATOR 3D Files/RECREATOR3D - Part 12 - Handle (esta de mas).stl

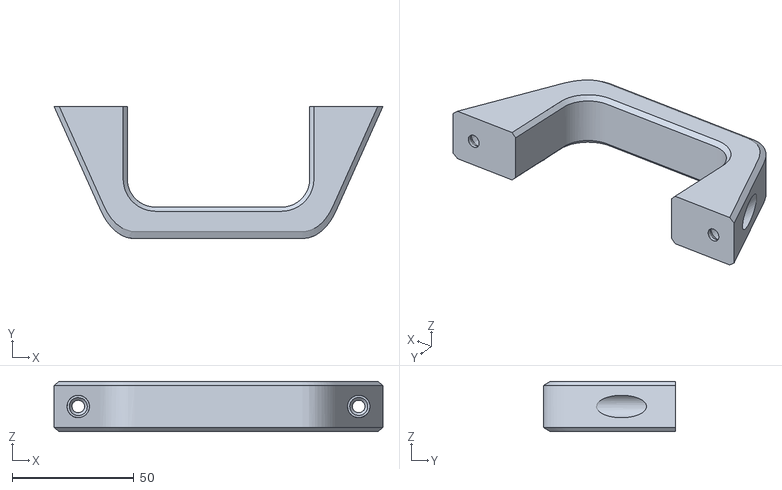
[picture p54: CAD file, 2023-06-16]
Modelos 3D/RECREATOR 3D Files/RECREATOR3D - Part 12 - Handle (esta de mas).stl
134.9 x 54.2 x 20.7
