Nicomedes77/PlasticBot_v1.0/Modelos 3D/RECREATOR 3D Files/RECREATOR3D - Part 1B - Filador de PET.stl

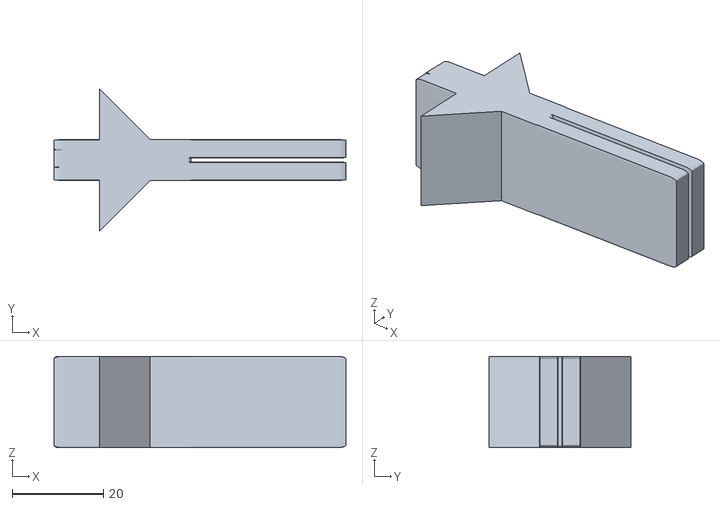
[picture p55: CAD file, 2023-06-16]
Modelos 3D/RECREATOR 3D Files/RECREATOR3D - Part 1B - Filador de PET.stl
64.0 x 31.1 x 20.0
