Nicomedes77/PlasticBot_v1.0/Modelos 3D/RECREATOR 3D Files/RECREATOR3D - Part 3 - Cooling Fan Plate.stl

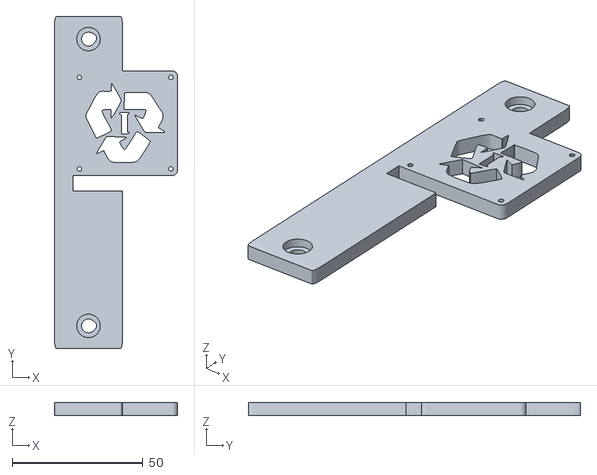
[picture p56: CAD file, 2023-06-16]
Modelos 3D/RECREATOR 3D Files/RECREATOR3D - Part 3 - Cooling Fan Plate.stl
47.0 x 127.0 x 5.00
