Nicomedes77/PlasticBot_v1.0/Modelos 3D/RECREATOR 3D Files/The Recreator 3D Token (esta de mas).stl

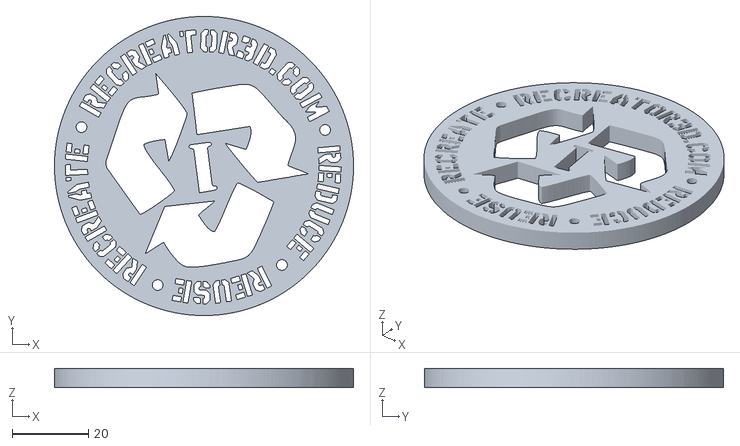
[picture p57: CAD file, 2023-06-16]
Modelos 3D/RECREATOR 3D Files/The Recreator 3D Token (esta de mas).stl
78.6 x 78.6 x 5.00
