Nicomedes77/PlasticBot_v1.0/Modelos 3D/RECREATOR 3D Files/RECREATOR3D - Part 5B - Soporte bobina colectora de filamento - PRO - DUAL MOTOR 11-11 UPDATE.stl.stl

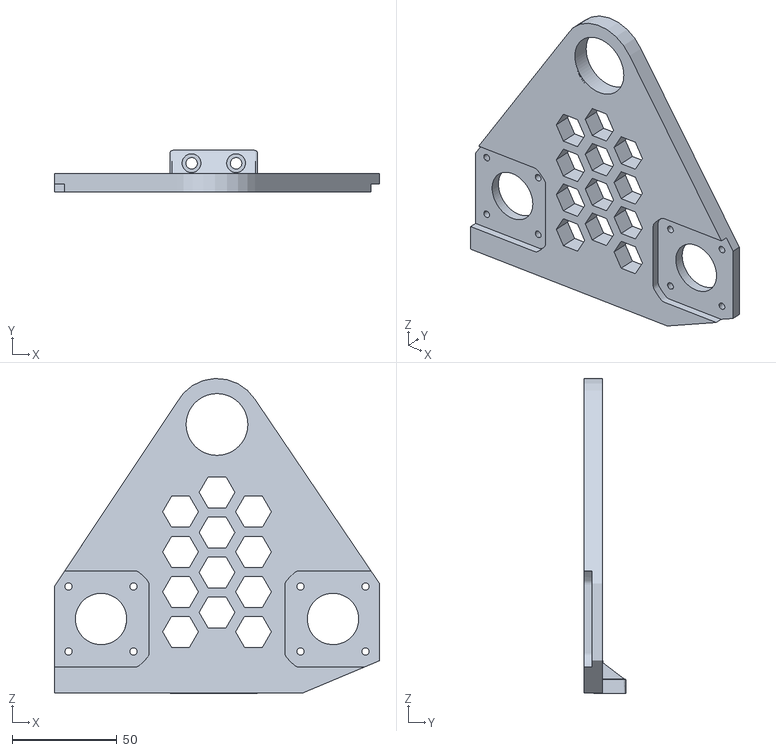
[picture p58: CAD file, 2023-06-16]
Modelos 3D/RECREATOR 3D Files/RECREATOR3D - Part 5B - Soporte bobina colectora de filamento - PRO - DUAL MOTOR 11-11 UPDATE.stl.stl
155.1 x 20.0 x 150.3
