Nicomedes77/PlasticBot_v1.0/Modelos 3D/RECREATOR 3D Files/RECREATOR3D - Part 11E-LITE- Front Sinage (esta de mas).stl

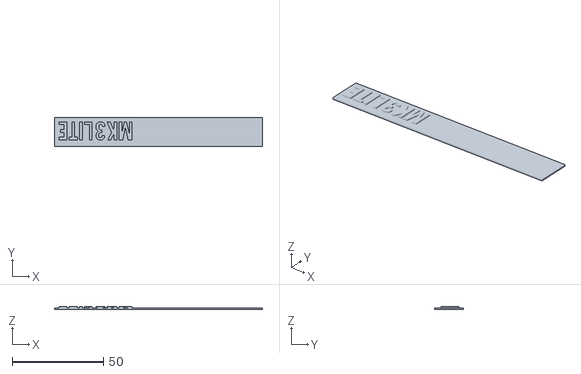
[picture p59: CAD file, 2023-06-16]
Modelos 3D/RECREATOR 3D Files/RECREATOR3D - Part 11E-LITE- Front Sinage (esta de mas).stl
113.7 x 16.0 x 1.60
