Nicomedes77/PlasticBot_v1.0/Modelos 3D/RECREATOR 3D Files/RECREATOR3D - Part 10A - Bottle Weight Bottom.stl

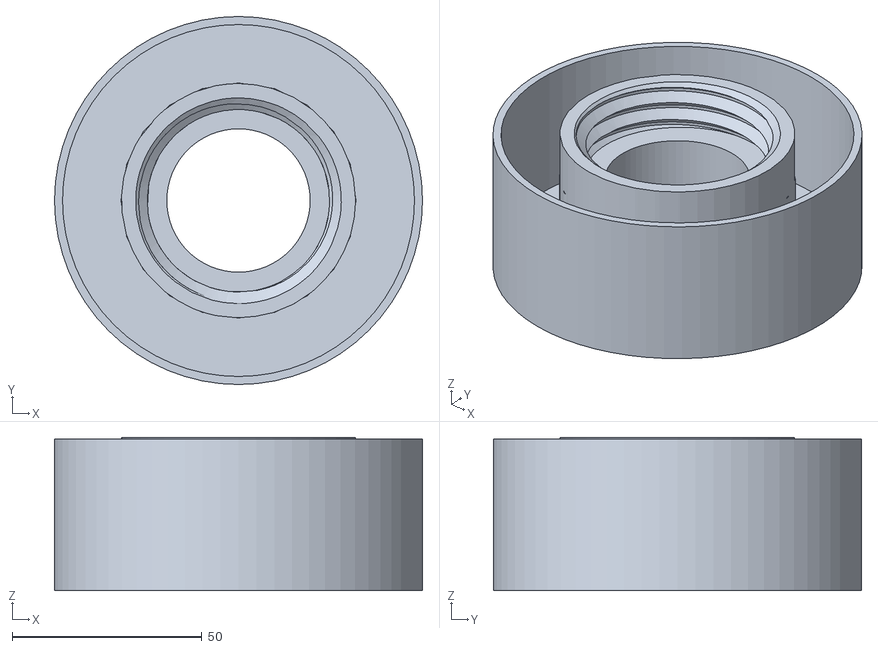
[picture p61: CAD file, 2023-06-16]
Modelos 3D/RECREATOR 3D Files/RECREATOR3D - Part 10A - Bottle Weight Bottom.stl
97.0 x 97.0 x 40.4
