Nicomedes77/PlasticBot_v1.0/Modelos 3D/RECREATOR 3D Files/The Recreator 3D Keychain (esta de mas).stl

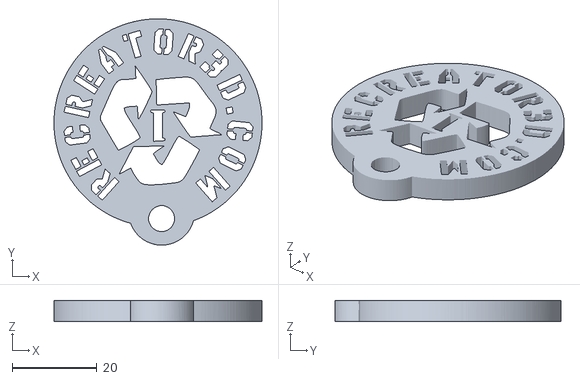
[picture p62: CAD file, 2023-06-16]
Modelos 3D/RECREATOR 3D Files/The Recreator 3D Keychain (esta de mas).stl
49.0 x 53.3 x 5.00
