Nicomedes77/PlasticBot_v1.0/(list of files, cad)

Other CAD files:
Modelos 3D/Hardware v1/archivos/guia tapa trasera (derecha).stl
Modelos 3D/Hardware v1/archivos/Encaste para bobina colectora (parte F).stl
Modelos 3D/RECREATOR 3D Files/RECREATOR3D - Part 4B - Orientador de filamento.stl
Modelos 3D/RECREATOR 3D Files/RECREATOR3D - Part 4E - Orientador de filamento.stl
Modelos 3D/RECREATOR 3D Files/RECREATOR3D - Part 7C - encaste para bobina colectora (rodamiento).stl
Modelos 3D/RECREATOR 3D Files/RECREATOR3D - Part 09B - Bottle Support Holder.stl
Modelos 3D/RECREATOR 3D Files/RECREATOR3D - Part 11D-PRO- Front Sinage (esta de mas).stl
