Nicomedes77/PlasticBot_v1.0/Planos maqueta/frente_atras.pdf

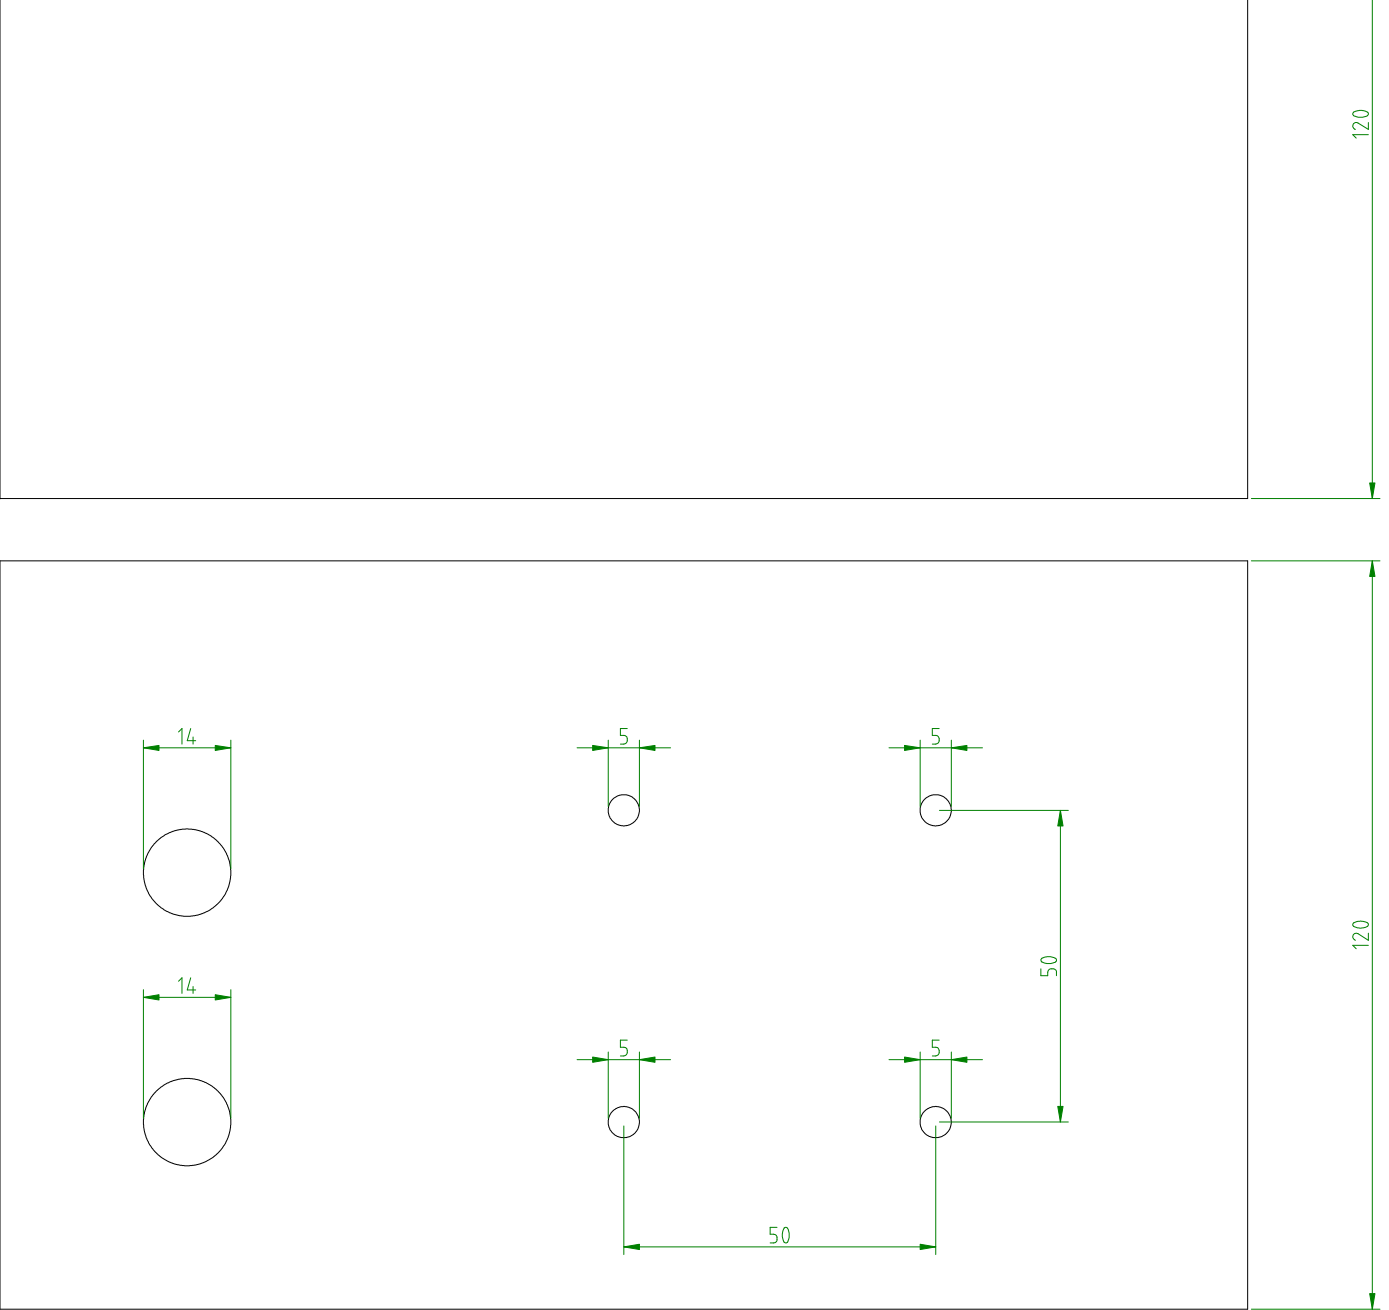
[picture p64: page 1]
