Nicomedes77/PlasticBot_v1.0/Planos maqueta/laterales.pdf

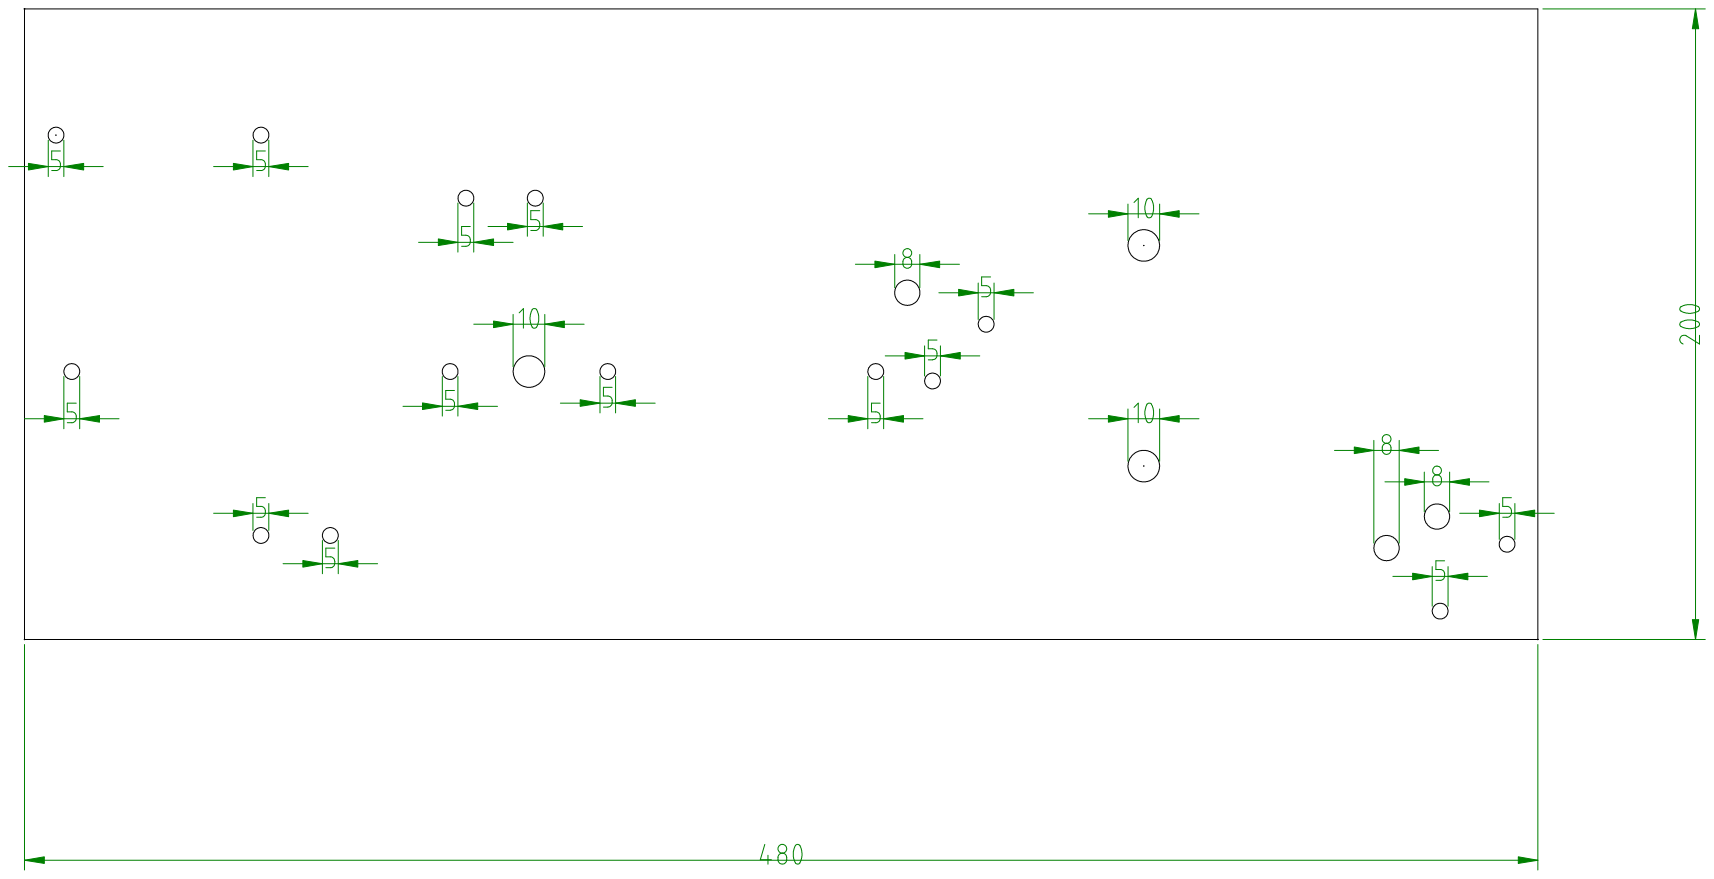
[picture p65: page 1]
