Nicomedes77/PlasticBot_v1.0/Planos maqueta/superior.pdf

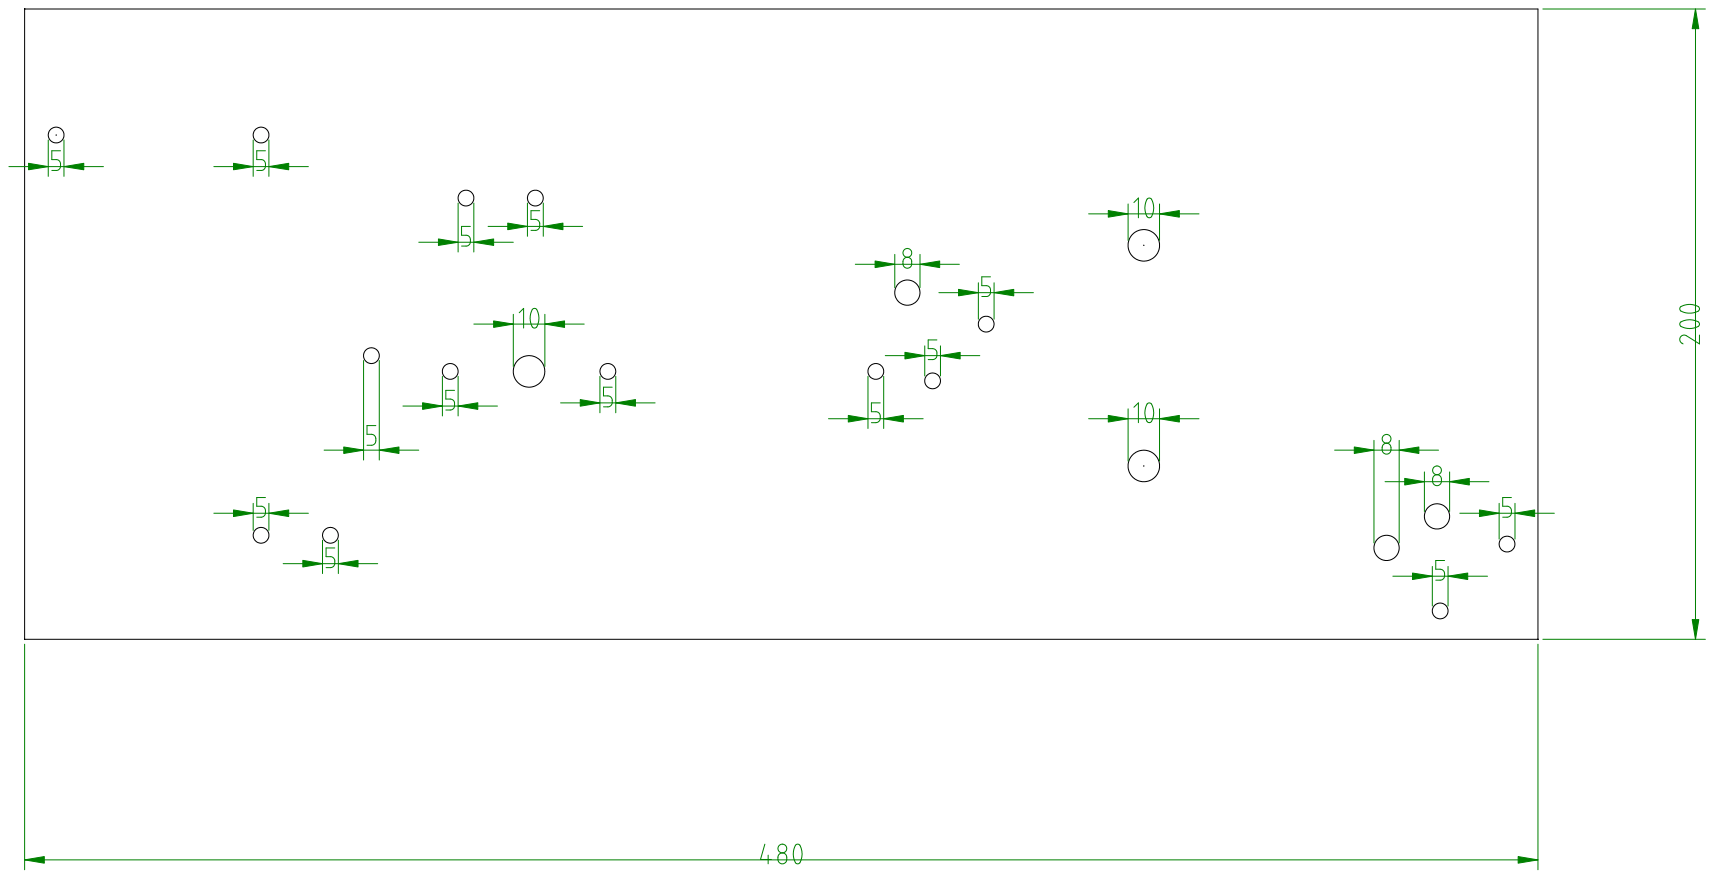
[picture p66: page 1]
