Nicomedes77/PlasticBot_v1.0/Firmware/PlasticBOT_v01/Core/Inc/main.h

#define RotaryDT_Pin GPIO_PIN_13
#define RotaryDT_GPIO_Port GPIOC
#define RotaryDT_EXTI_IRQn EXTI15_10_IRQn
#define RotaryCLK_Pin GPIO_PIN_14
#define RotaryCLK_GPIO_Port GPIOC
#define RotaryCLK_EXTI_IRQn EXTI15_10_IRQn
#define Button_Pin GPIO_PIN_15
#define Button_GPIO_Port GPIOC
#define Button_EXTI_IRQn EXTI15_10_IRQn
#define RESET_MOTOR1_Pin GPIO_PIN_0
#define RESET_MOTOR1_GPIO_Port GPIOA
#define PASOS_MOTOR1_Pin GPIO_PIN_2
#define PASOS_MOTOR1_GPIO_Port GPIOA
#define Buzzer_Pin GPIO_PIN_10
#define Buzzer_GPIO_Port GPIOB
#define CALENTADOR1_Pin GPIO_PIN_11
#define CALENTADOR1_GPIO_Port GPIOB
#define Led_Pin GPIO_PIN_15
#define Led_GPIO_Port GPIOA
#define Detector_fil_Pin GPIO_PIN_3
#define Detector_fil_GPIO_Port GPIOB
#define Detector_fil_EXTI_IRQn EXTI3_IRQn
#define NUMTEMPS 25
