Nicomedes77/PlasticBot_v1.0/(commit log)

2023-06-16 adición de archivos principales
    [BOM.xlsx]
2023-06-16 Agregado de imagenes y planos
    [Encaste para bobina colectora (parte A).stl, Encaste para bobina colectora (parte A)v2.stl, Encaste para bobina colectora (parte B).stl, Encaste para bobina colectora (parte C).stl, Encaste para bobina colectora (parte D).stl, Encaste para bobina colectora (parte E).stl, Encaste para bobina colectora (parte F).stl, Encaste para bobina colectora (parte G).stl]
