Nicomedes77/PlasticBot_v1.0/(notices)

Notices in the files:
Firmware/PlasticBOT_v01/Core/Src/main.c:
© Copyright (c) 2022 STMicroelectronics.
All rights reserved.
This software component is licensed by ST under BSD 3-Clause license,
the "License"; You may not use this file except in compliance with the
License. You may obtain a copy of the License at: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
Firmware/PlasticBOT_v01/Core/Inc/main.h:
Copyright (c) 2022 STMicroelectronics.
This software is licensed under terms that can be found in the LICENSE file
(C) COPYRIGHT STMicroelectronics *****END OF FILE
